new-production-institute/OSAMBot/README.md

# OSAMBot

## Introduction

OSAMBot is a low-cost, open-source, modular telescopic robot designed to support
precision farming through adaptable, locally manufacturable automation.

## Description

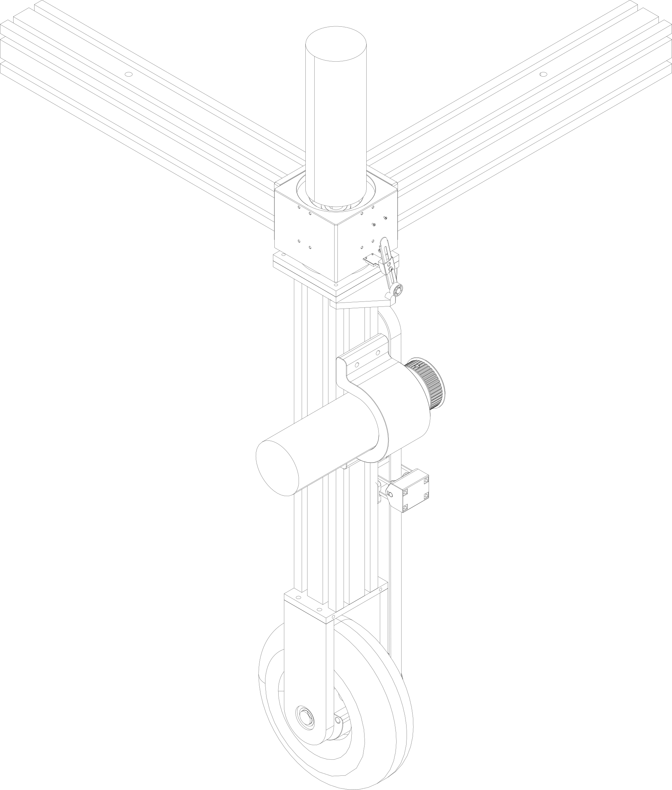
[picture p1: robotic-platform-v1/res/assets/img/osambot.png]
Description


This robot is a low-cost, modular telescopic autonomous agricultural platform
designed to support precision farming. It addresses challenges caused by climate
change. The open-source hardware design follows Fab City principles, aiming to
provide flexible, locally producible robotic solutions for tasks such as
seeding, weeding, and maintaining farm operations.

## Repository structure

The repository is structured with a top-level folder for each version of the
robotic platform, and inside each version directory the files are organized into
`build` (generated STL files), `doc` (documentation), `res` (e.g. datasheets,
manufacturing files, and CAD working assets), and `src` (the main mechanical CAD
assemblies and components).

## License

See the LICENSES folder and the SPDX metadata for more details.  The project is
[REUSE](https://reuse.software/) compliant.

## Authors
- Durga Prasad Babu Nasika (Version 0 and 1)
- SJ (Version 1)
- Joel Romero (Version 0)
- J.C. Mariscal-Melgar (Documentation)

## Acknowledgement
The project "Fab City – Decentralized Digital Production for Urban Value Creation" is funded by dtec.bw and supported by the European Union – NextGenerationEU.
