new-production-institute/OSAMBot/robotic-platform-v1/doc/concept-design/2D-ConceptualDesign-Drive.pdf

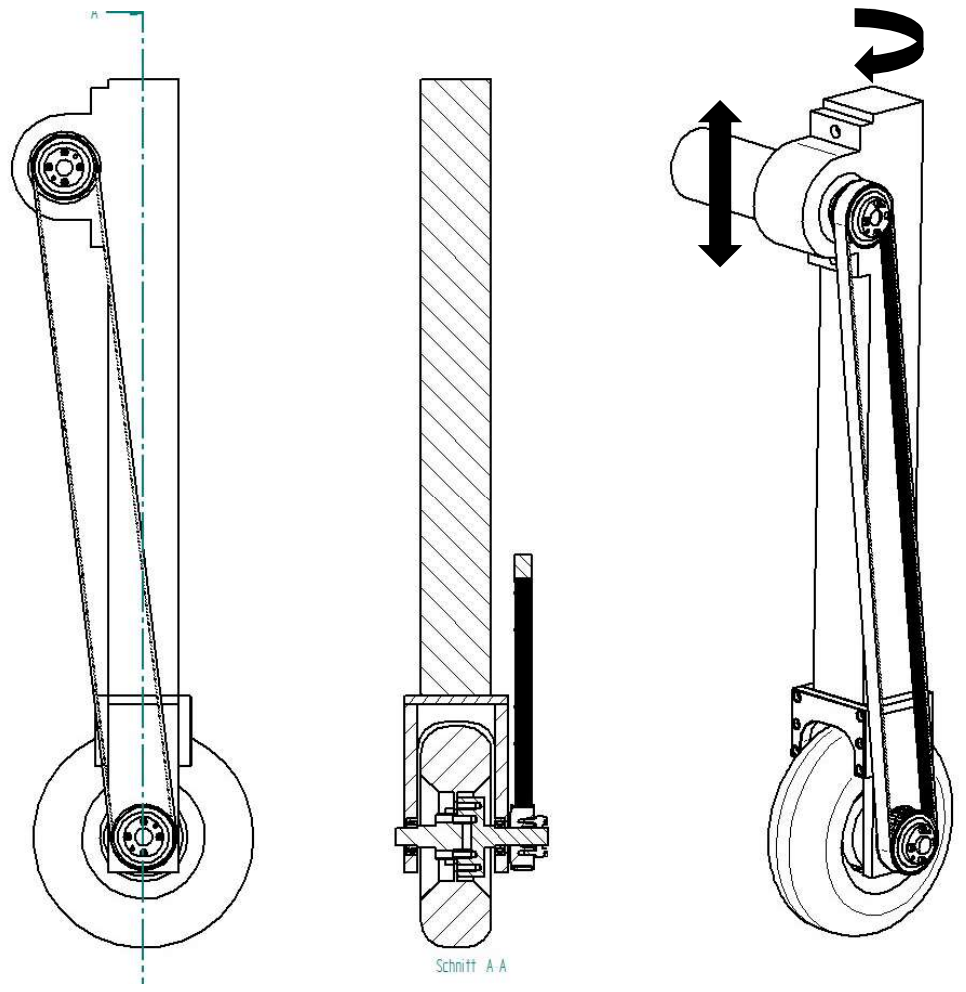
[picture p2: page 1]
