new-production-institute/OSAMBot/robotic-platform-v1/doc/concept-design/2D-ConceptualDesign-Drive.jpg

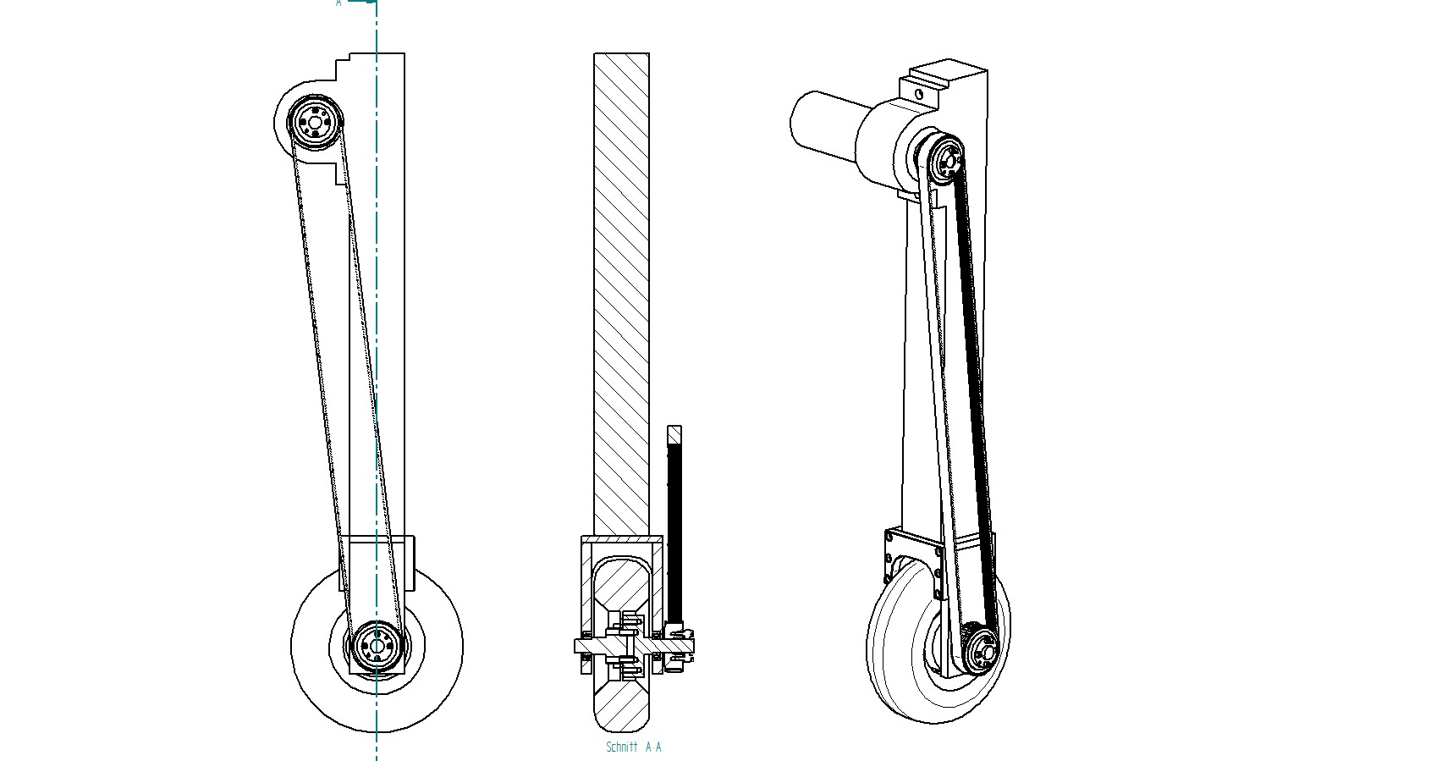
robotic-platform-v1/doc/concept-design/2D-ConceptualDesign-Drive.jpg
