new-production-institute/OSAMBot/robotic-platform-v1/src/mech/assembly-robotic-platform.stp

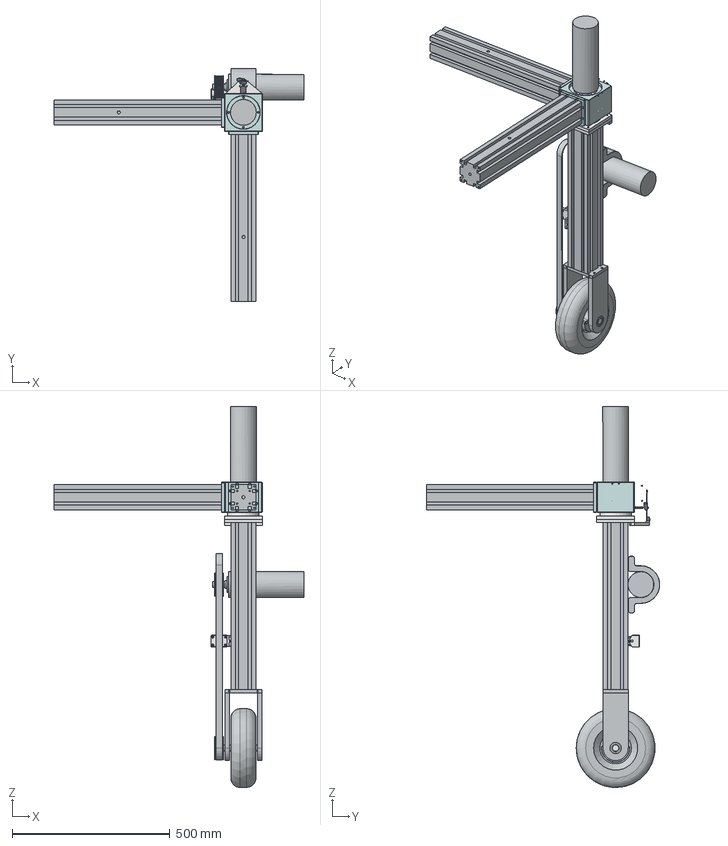
[picture p4: CAD file, 2025-08-19]
robotic-platform-v1/src/mech/assembly-robotic-platform.stp
791.7 x 739.6 x 1207.7 mm
wheel-Maxxis-M-9230TT-252504W-004
vertical-profile-adapter-plate
radial-bearing-6004ZZC3 x 2
bearing-696AZZ x 2
RiemenRolle
pin-D6
Federspanner
drive-shaft-holder(PLA)
profile-adapter-plate-24.03.25 x 2
wheel-bearing-plate x 2
Motor-PL82Z-BL82.137-24300-30S-192_1-ENC1096 x 2
M4x50 x 4
80x80-profile x 3
top-wheel-bearing-plate
drive-shaft-holder-cutout(PLA)
belt
TTLA44T5200-E-20_b-D19-PR
TTLA44T5200-E-20_b-D20-PR
drive-shaft-D20L150
vertical-profile-adapter-plate2
Limit switch ME-8108 x 2
Limit switch ME-8108_0
Limit switch ME-8108_1
Limit switch ME-8108_2 x 3
Limit switch ME-8108_3
Limit switch ME-8108_4
Limit switch ME-8108_5
Limit switch ME-8108_6
Limit switch ME-8108_7
Limit switch ME-8108_8
Limit switch ME-8108_9
radial-bearing x 2
belt-tensioner-angle
limit-switch-plate
drive-motor-holder
bearing-limit-ring
belt-tensioner-angle-glider
steering-motor-adapter-24.03.25
axial-bearing
steering-motor-adapter-shaft
