new-production-institute/OSAMBot/robotic-platform-v1/res/assets/var/manufacturing/02.04.25/drive-shaft-holder_ALU.stp

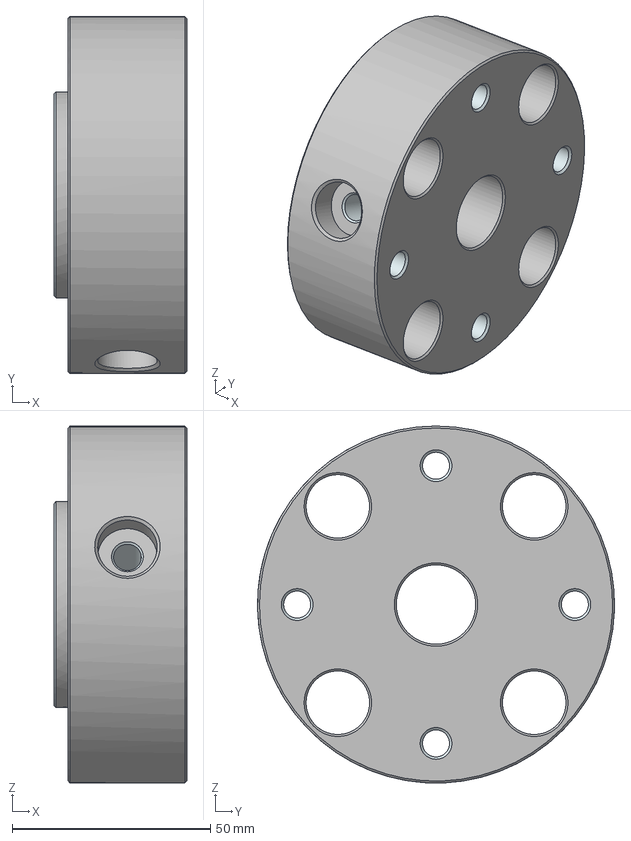
[picture p6: CAD file, 2025-08-19]
robotic-platform-v1/res/assets/var/manufacturing/02.04.25/drive-shaft-holder_ALU.stp
33.5 x 90.0 x 90.0 mm
