new-production-institute/OSAMBot/robotic-platform-v1/res/assets/var/manufacturing/24.03.25/Motorplate.stp

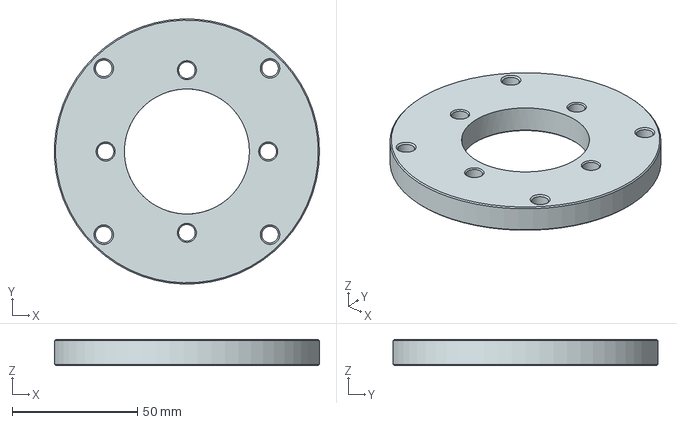
[picture p7: CAD file, 2025-08-19]
robotic-platform-v1/res/assets/var/manufacturing/24.03.25/Motorplate.stp
105.9 x 106.0 x 10.5 mm
