new-production-institute/OSAMBot/robotic-platform-v1/res/assets/var/working-files/helping-prints/Laser alignment/L-Holder.stl

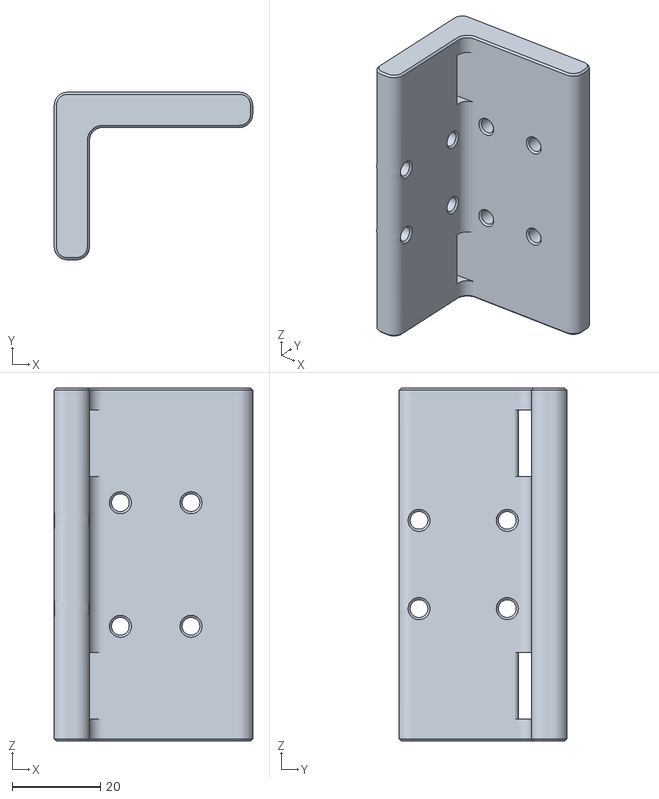
[picture p8: CAD file, 2025-08-19]
robotic-platform-v1/res/assets/var/working-files/helping-prints/Laser alignment/L-Holder.stl
45.0 x 38.0 x 80.0
