new-production-institute/OSAMBot/robotic-platform-v1/res/assets/var/working-files/helping-prints/RK-30-Lifter.stl

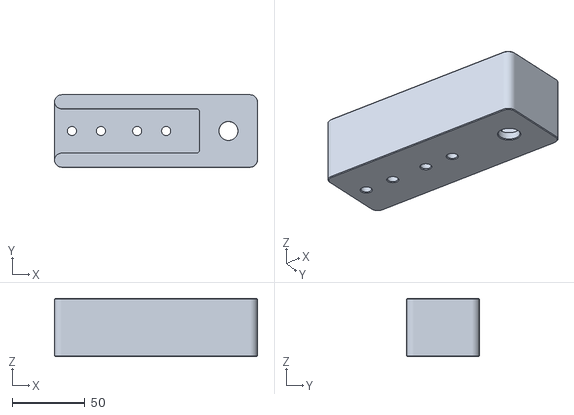
[picture p9: CAD file, 2025-08-19]
robotic-platform-v1/res/assets/var/working-files/helping-prints/RK-30-Lifter.stl
140.0 x 50.0 x 40.0
