new-production-institute/OSAMBot/robotic-platform-v1/res/assets/var/working-files/laser-parts/LensHolder80W-Galvo-side.stl

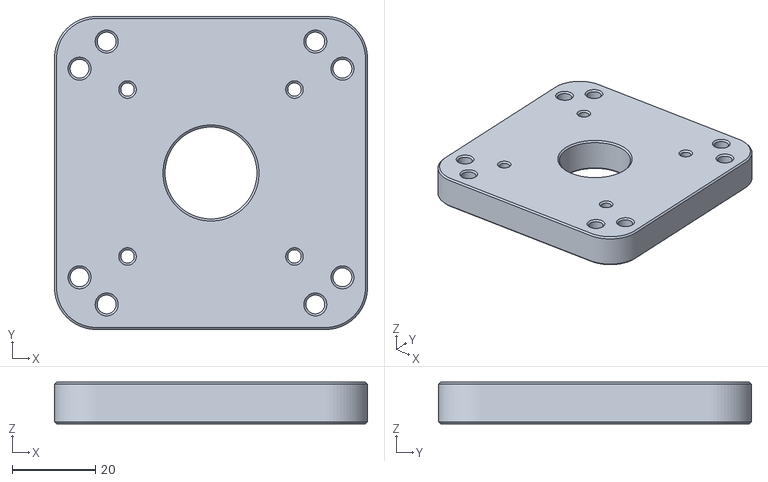
[picture p10: CAD file, 2025-08-19]
robotic-platform-v1/res/assets/var/working-files/laser-parts/LensHolder80W-Galvo-side.stl
75.0 x 75.0 x 10.0
