new-production-institute/OSAMBot/robotic-platform-v1/res/assets/var/working-files/simplified-model/Wheel.stp

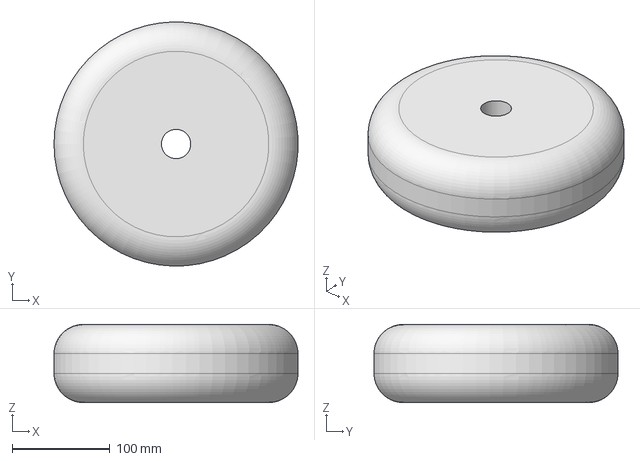
[picture p11: CAD file, 2025-08-19]
robotic-platform-v1/res/assets/var/working-files/simplified-model/Wheel.stp
249.8 x 249.9 x 80.0 mm
