new-production-institute/OSAMBot/robotic-platform-v1/src/mech/assembly-robotic-platform-individual-parts/drive-motor-holder.stp

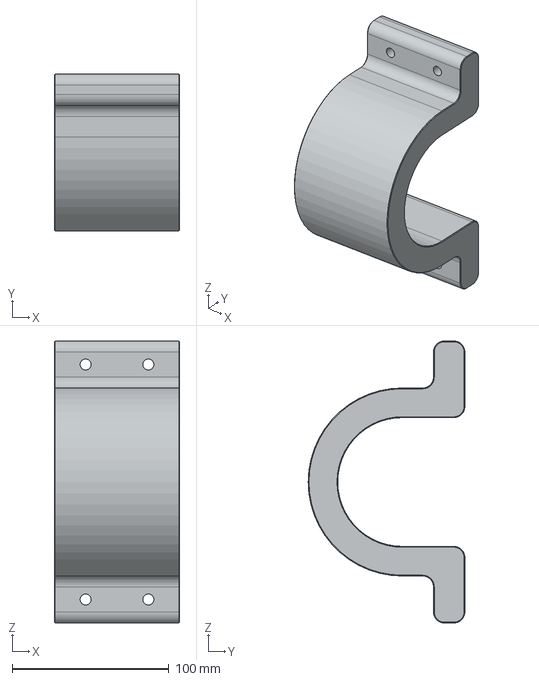
[picture p12: CAD file, 2025-08-19]
robotic-platform-v1/src/mech/assembly-robotic-platform-individual-parts/drive-motor-holder.stp
80.0 x 100.0 x 180.0 mm
