new-production-institute/OSAMBot/robotic-platform-v1/build/TTLA44T5200-E-20_b-D20-PR.stl

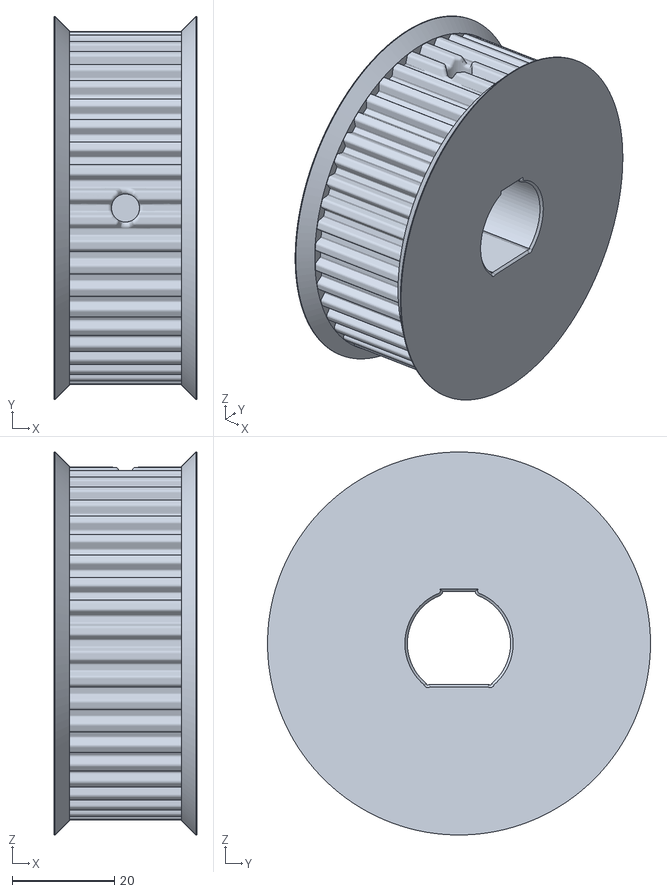
[picture p13: CAD file, 2025-08-19]
robotic-platform-v1/build/TTLA44T5200-E-20_b-D20-PR.stl
28.0 x 75.0 x 75.0
