new-production-institute/OSAMBot/robotic-platform-v1/res/assets/var/manufacturing/24.03.25/ProfilAdapterplate-24.03.25.stp

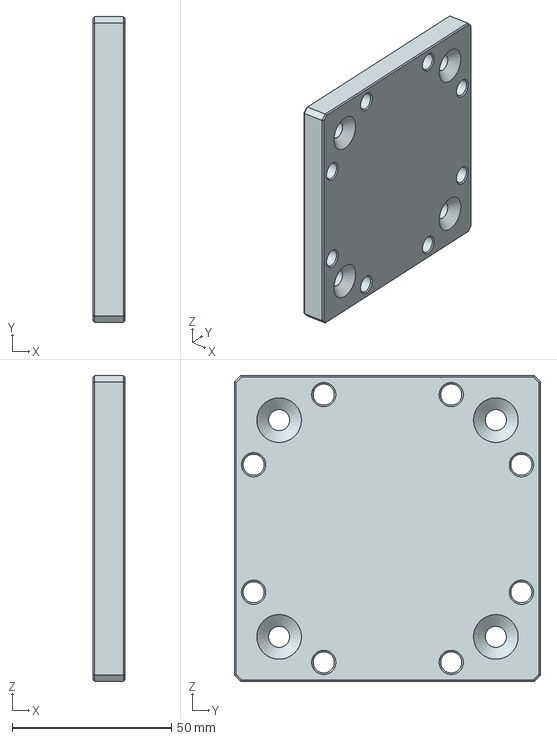
[picture p14: CAD file, 2025-08-19]
robotic-platform-v1/res/assets/var/manufacturing/24.03.25/ProfilAdapterplate-24.03.25.stp
10.0 x 96.0 x 96.0 mm
