new-production-institute/OSAMBot/robotic-platform-v1/res/assets/var/working-files/helping-prints/Distanzring.stl

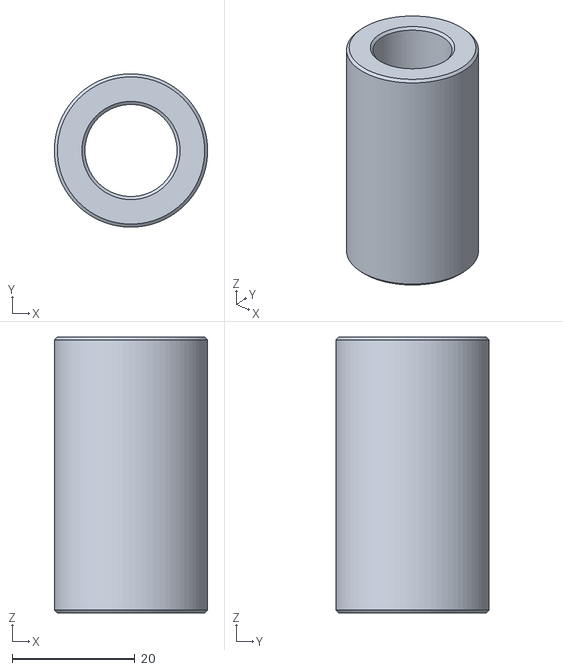
[picture p15: CAD file, 2025-08-19]
robotic-platform-v1/res/assets/var/working-files/helping-prints/Distanzring.stl
25.0 x 25.0 x 45.0
