new-production-institute/OSAMBot/robotic-platform-v1/res/assets/var/working-files/helping-prints/Laser alignment/Cover-L-Side.stl

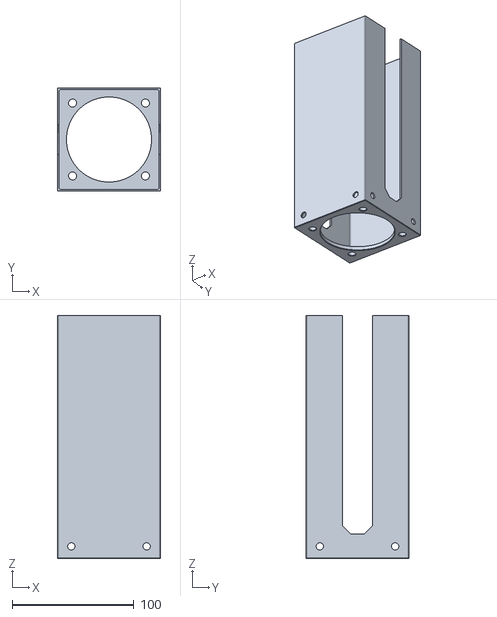
[picture p16: CAD file, 2025-08-19]
robotic-platform-v1/res/assets/var/working-files/helping-prints/Laser alignment/Cover-L-Side.stl
85.0 x 85.0 x 200.0
