new-production-institute/OSAMBot/robotic-platform-v1/res/assets/var/working-files/laser-parts/LensHolder80W-Laser-side.stl

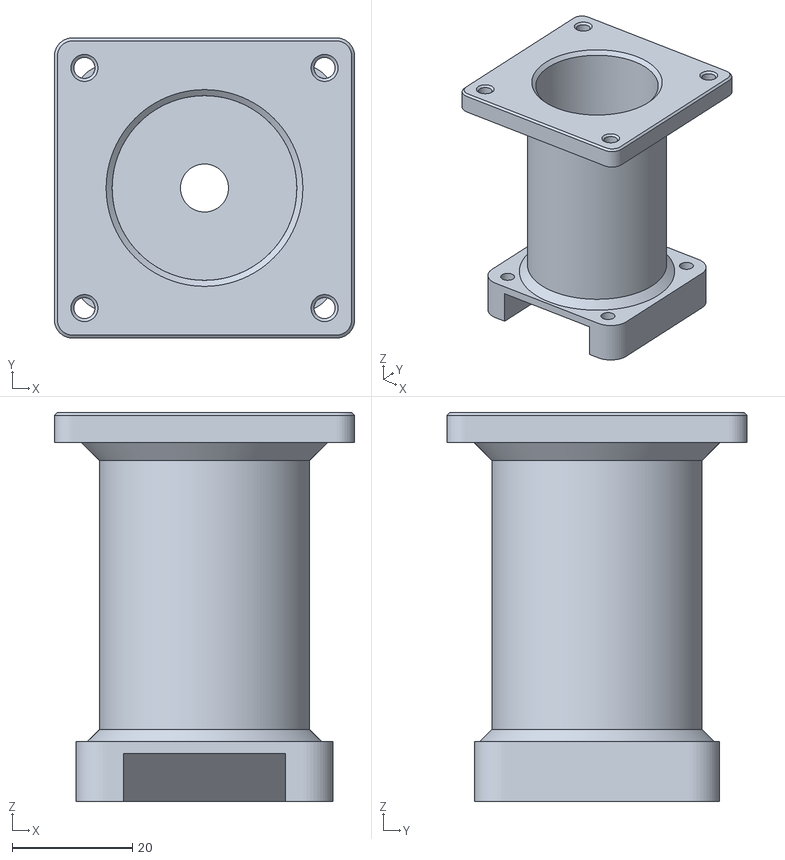
[picture p17: CAD file, 2025-08-19]
robotic-platform-v1/res/assets/var/working-files/laser-parts/LensHolder80W-Laser-side.stl
50.0 x 50.0 x 64.8
