new-production-institute/OSAMBot/robotic-platform-v1/res/assets/var/working-files/simplified-model/Leg.stp

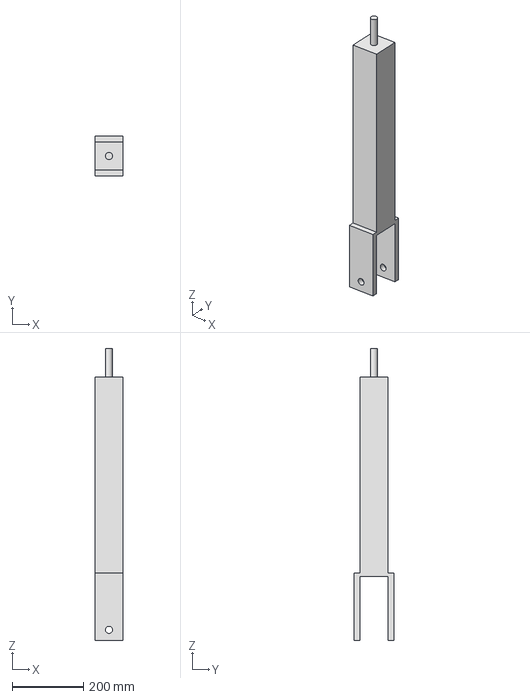
[picture p18: CAD file, 2025-08-19]
robotic-platform-v1/res/assets/var/working-files/simplified-model/Leg.stp
80.0 x 112.0 x 820.0 mm
