new-production-institute/OSAMBot/robotic-platform-v1/src/mech/assembly-robotic-platform-individual-parts/Limit switch ME-8108.stp

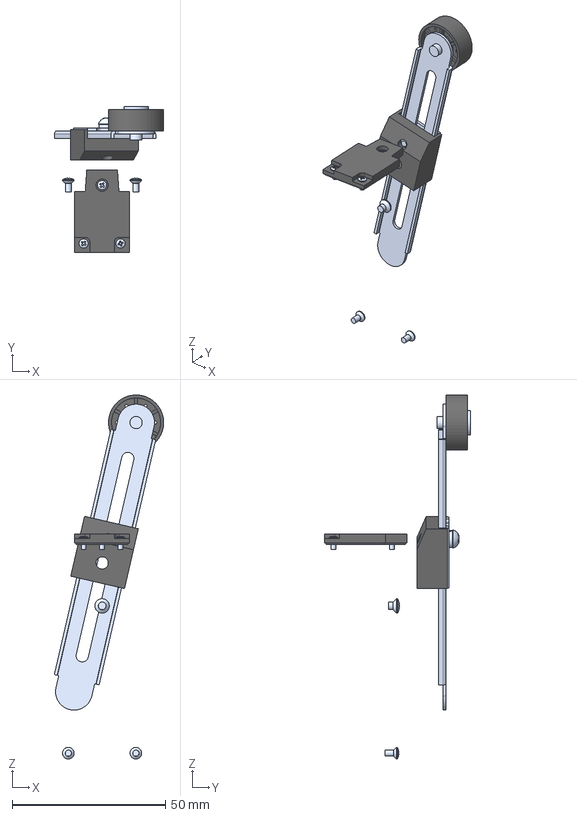
[picture p19: CAD file, 2025-08-19]
robotic-platform-v1/src/mech/assembly-robotic-platform-individual-parts/Limit switch ME-8108.stp
35.6 x 47.7 x 118.6 mm
Limit switch ME-8108 x 2
Limit switch ME-8108_0
Limit switch ME-8108_1
Limit switch ME-8108_2 x 3
Limit switch ME-8108_3
Limit switch ME-8108_4
Limit switch ME-8108_5
Limit switch ME-8108_6
Limit switch ME-8108_7
Limit switch ME-8108_8
Limit switch ME-8108_9
