new-production-institute/OSAMBot/robotic-platform-v1/res/assets/var/manufacturing/24.03.25/SteeringMotorAdapter-24.03.25.stp

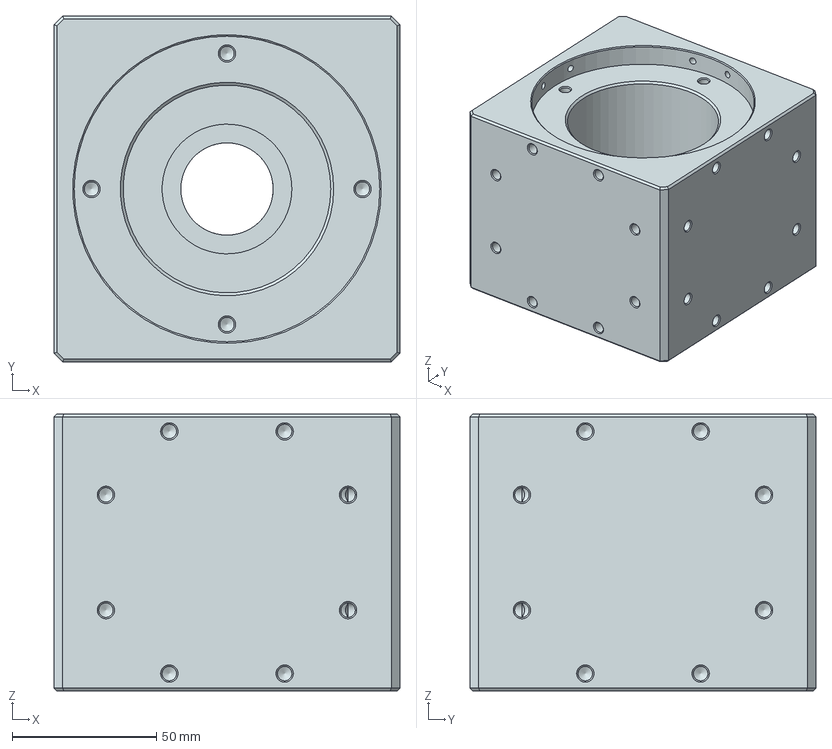
[picture p20: CAD file, 2025-08-19]
robotic-platform-v1/res/assets/var/manufacturing/24.03.25/SteeringMotorAdapter-24.03.25.stp
120.0 x 120.0 x 96.0 mm
