new-production-institute/OSAMBot/robotic-platform-v1/res/assets/var/working-files/helping-prints/Laser alignment/Linear-Holder.stl

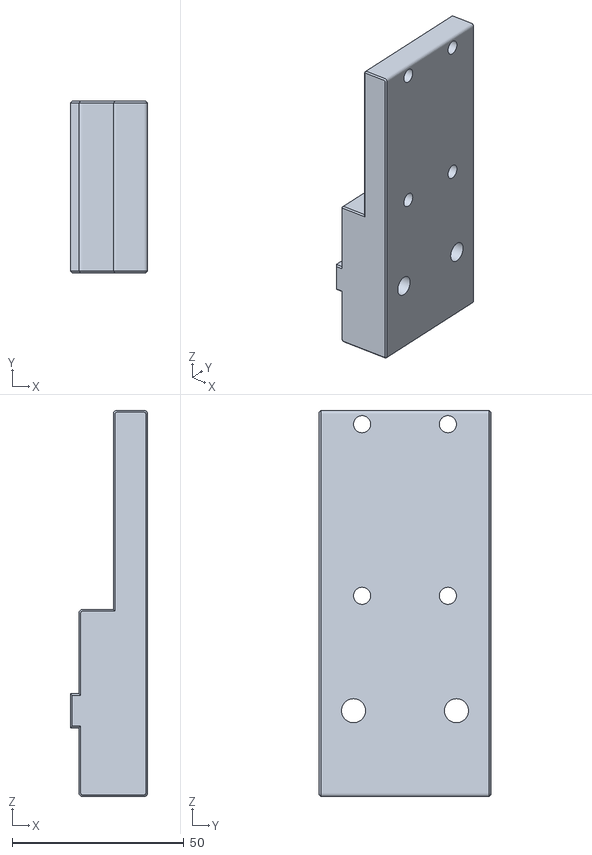
[picture p21: CAD file, 2025-08-19]
robotic-platform-v1/res/assets/var/working-files/helping-prints/Laser alignment/Linear-Holder.stl
22.5 x 50.0 x 112.5
