new-production-institute/OSAMBot/robotic-platform-v1/res/assets/var/working-files/helping-prints/M12-Guide.stl

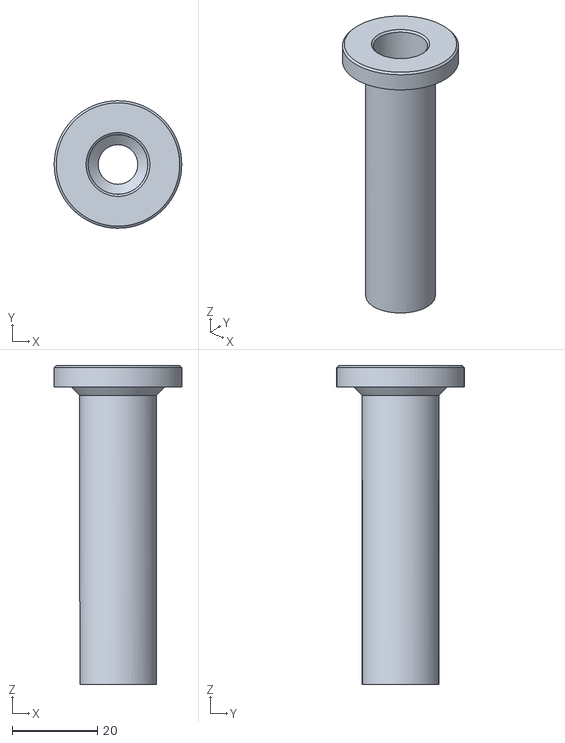
[picture p22: CAD file, 2025-08-19]
robotic-platform-v1/res/assets/var/working-files/helping-prints/M12-Guide.stl
30.0 x 30.0 x 75.0
