new-production-institute/OSAMBot/robotic-platform-v1/res/assets/var/working-files/simplified-model/Simplified-Joint-Model.stp

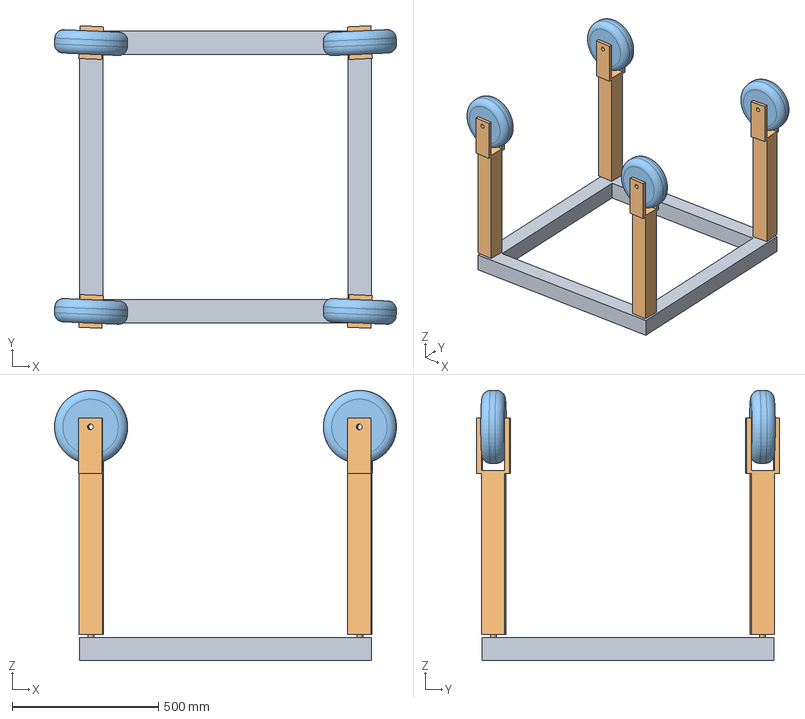
[picture p23: CAD file, 2025-08-19]
robotic-platform-v1/res/assets/var/working-files/simplified-model/Simplified-Joint-Model.stp
1170.6 x 1035.5 x 925.0 mm
Frame
Leg x 4
Wheel x 4
