new-production-institute/OSAMBot/robotic-platform-v1/src/mech/assembly-robotic-platform-individual-parts/top-wheel-bearing-plate.stp

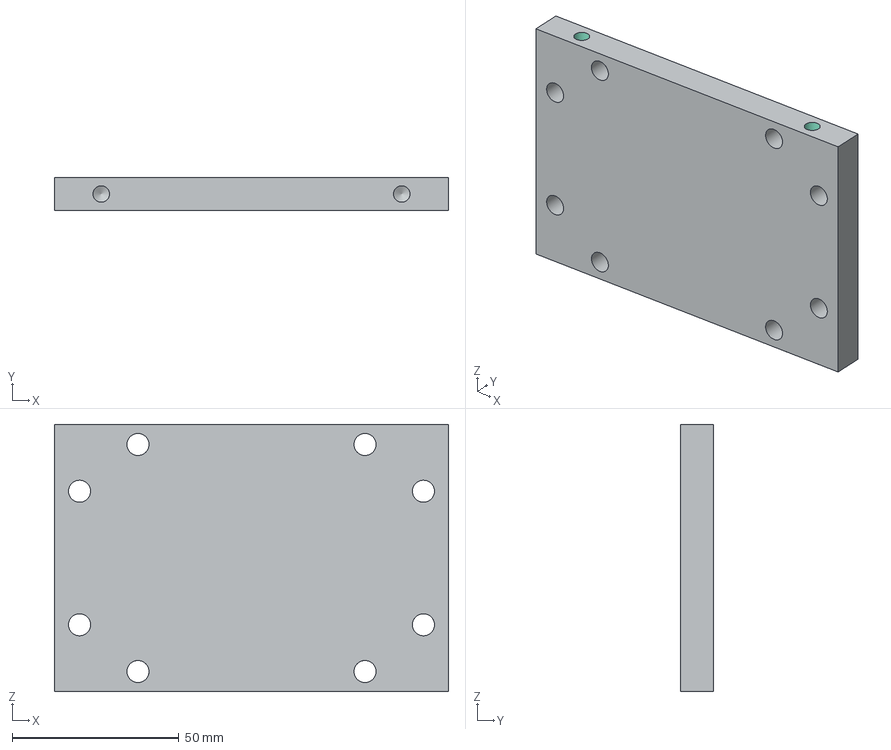
[picture p24: CAD file, 2025-08-19]
robotic-platform-v1/src/mech/assembly-robotic-platform-individual-parts/top-wheel-bearing-plate.stp
118.0 x 10.0 x 80.0 mm
