new-production-institute/OSAMBot/robotic-platform-v1/build/belt-tensioner-angle-glider.stl

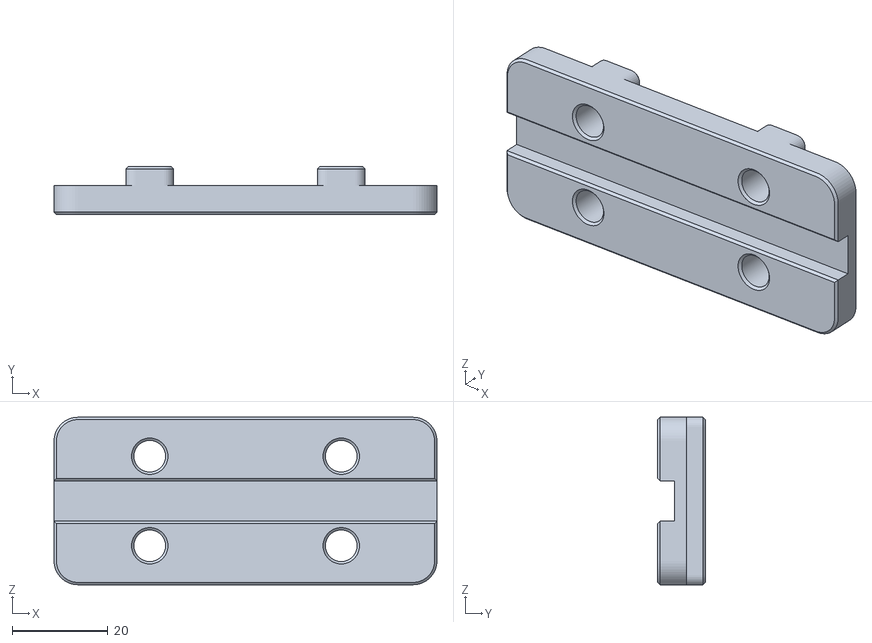
[picture p25: CAD file, 2025-08-19]
robotic-platform-v1/build/belt-tensioner-angle-glider.stl
80.0 x 10.0 x 35.0
