new-production-institute/OSAMBot/robotic-platform-v1/res/assets/var/working-files/helping-prints/drilling-template-3.stl

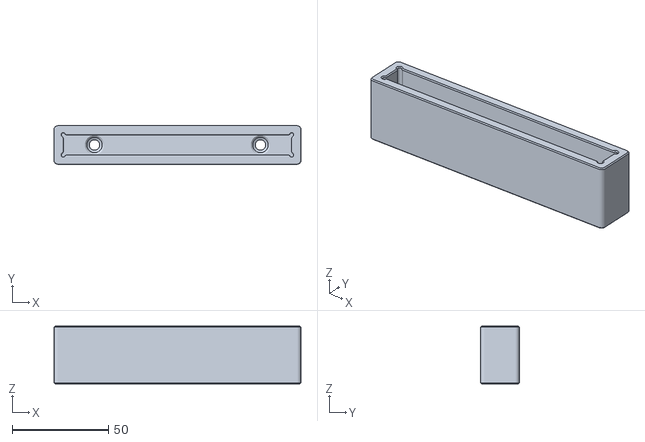
[picture p26: CAD file, 2025-08-19]
robotic-platform-v1/res/assets/var/working-files/helping-prints/drilling-template-3.stl
128.0 x 20.0 x 30.0
