new-production-institute/OSAMBot/robotic-platform-v1/res/assets/var/working-files/helping-prints/Laser alignment/L-HolderV2-T2.stl

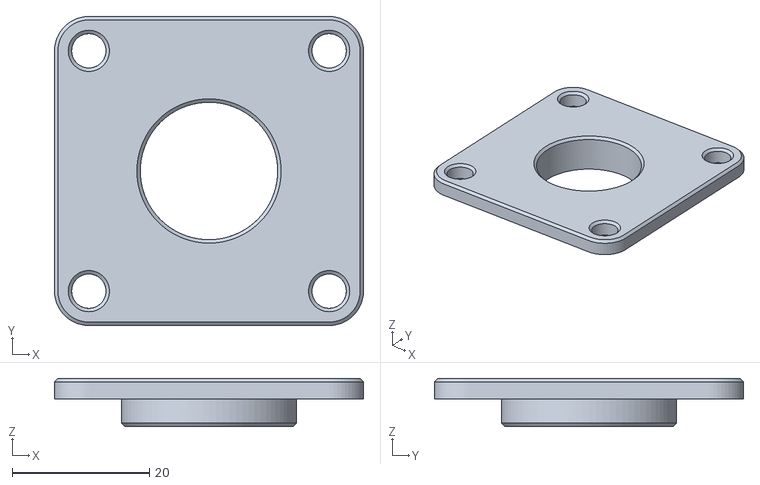
[picture p27: CAD file, 2025-08-19]
robotic-platform-v1/res/assets/var/working-files/helping-prints/Laser alignment/L-HolderV2-T2.stl
45.0 x 45.0 x 7.00
