new-production-institute/OSAMBot/robotic-platform-v1/res/assets/var/working-files/simplified-model/Frame.stp

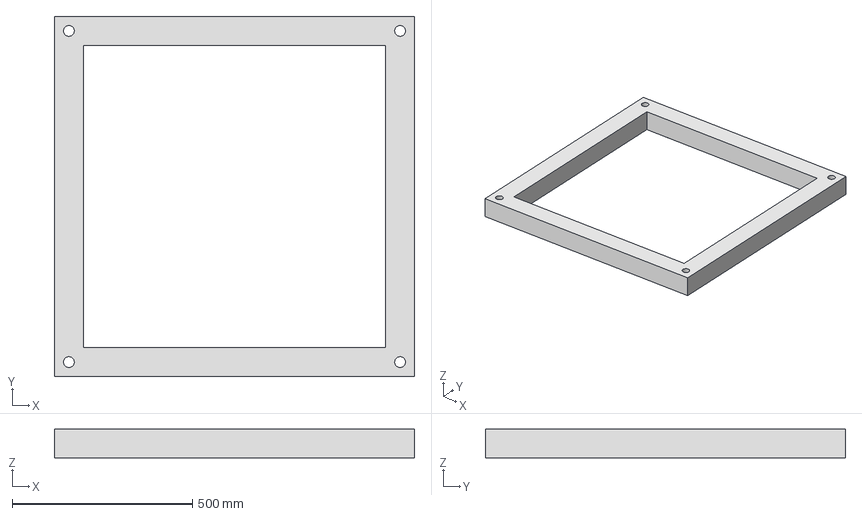
[picture p28: CAD file, 2025-08-19]
robotic-platform-v1/res/assets/var/working-files/simplified-model/Frame.stp
1000.0 x 1000.0 x 80.0 mm
