new-production-institute/OSAMBot/robotic-platform-v1/build/Zahnrad-Profil-8M-P24-8M-20-6F.stl

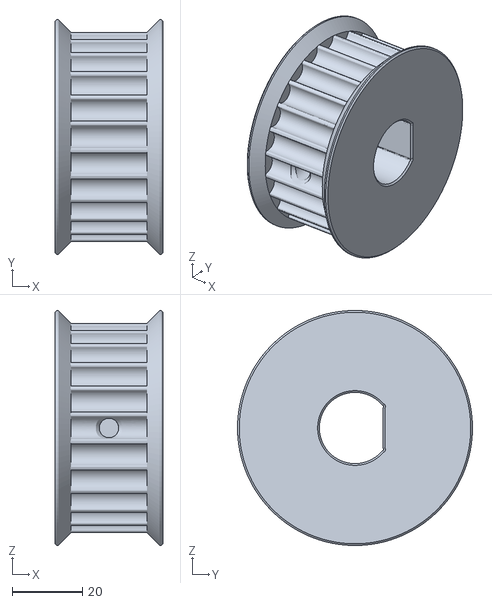
[picture p29: CAD file, 2025-08-19]
robotic-platform-v1/build/Zahnrad-Profil-8M-P24-8M-20-6F.stl
30.7 x 66.7 x 66.7
