new-production-institute/OSAMBot/robotic-platform-v1/res/assets/var/working-files/helping-prints/Laser alignment/Tube-inner.stl

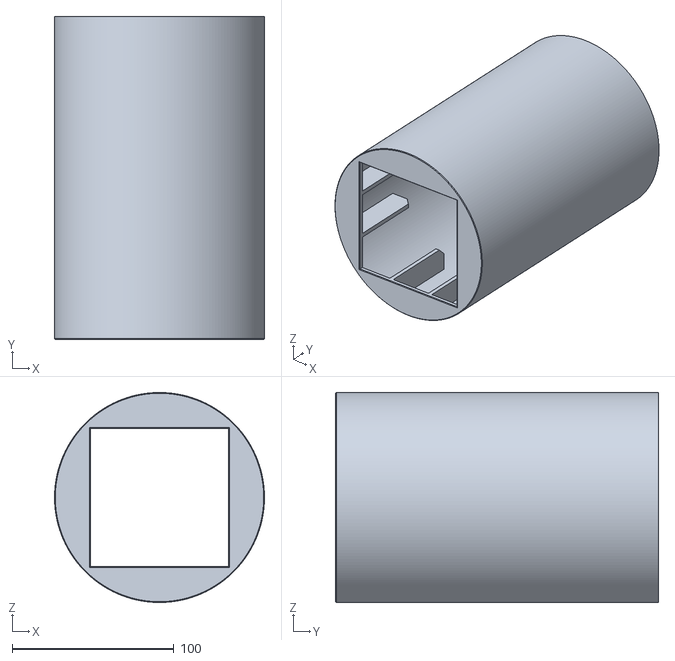
[picture p30: CAD file, 2025-08-19]
robotic-platform-v1/res/assets/var/working-files/helping-prints/Laser alignment/Tube-inner.stl
130.0 x 200.0 x 130.0
