new-production-institute/OSAMBot/robotic-platform-v1/res/assets/var/working-files/helping-prints/M12-Stuetze.stl

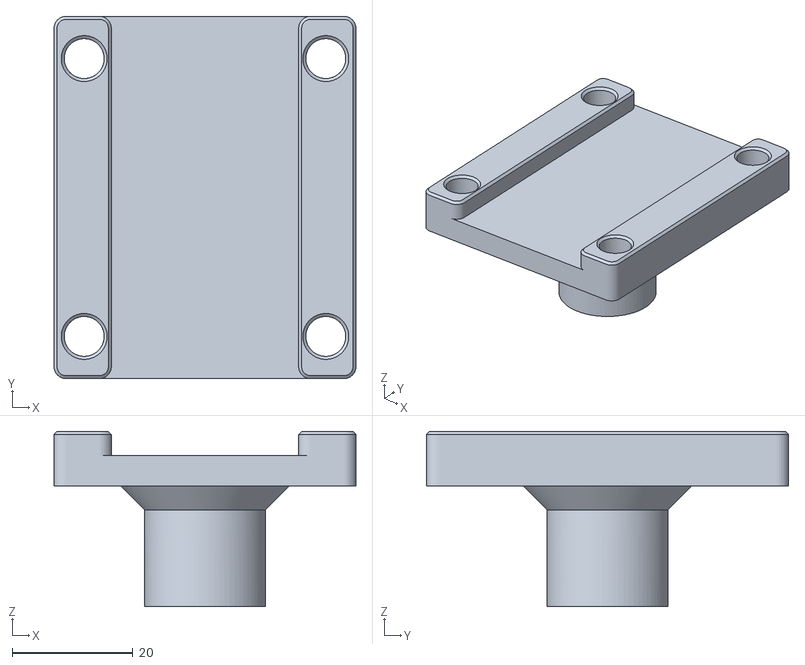
[picture p31: CAD file, 2025-08-19]
robotic-platform-v1/res/assets/var/working-files/helping-prints/M12-Stuetze.stl
50.0 x 60.0 x 29.0
