new-production-institute/OSAMBot/robotic-platform-v1/src/mech/assembly-robotic-platform-individual-parts/drive-shaft-holder(PLA).stp

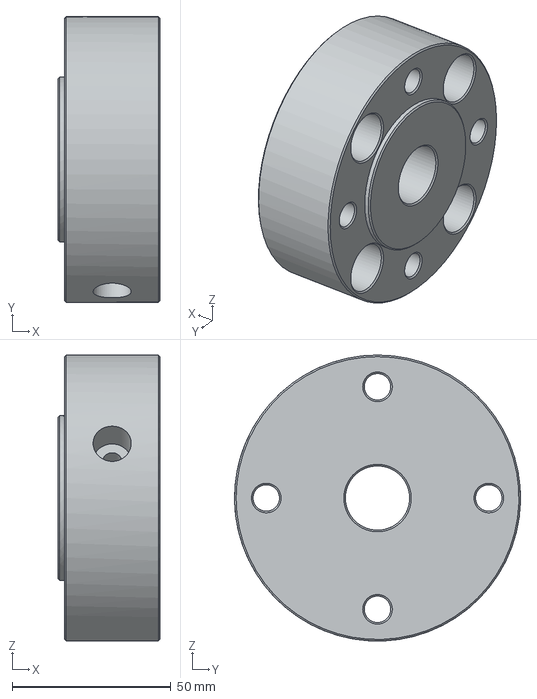
[picture p32: CAD file, 2025-08-19]
robotic-platform-v1/src/mech/assembly-robotic-platform-individual-parts/drive-shaft-holder(PLA).stp
32.0 x 90.0 x 90.0 mm
