new-production-institute/OSAMBot/robotic-platform-v1/build/drive-shaft-holder-cutout(PLA).stl

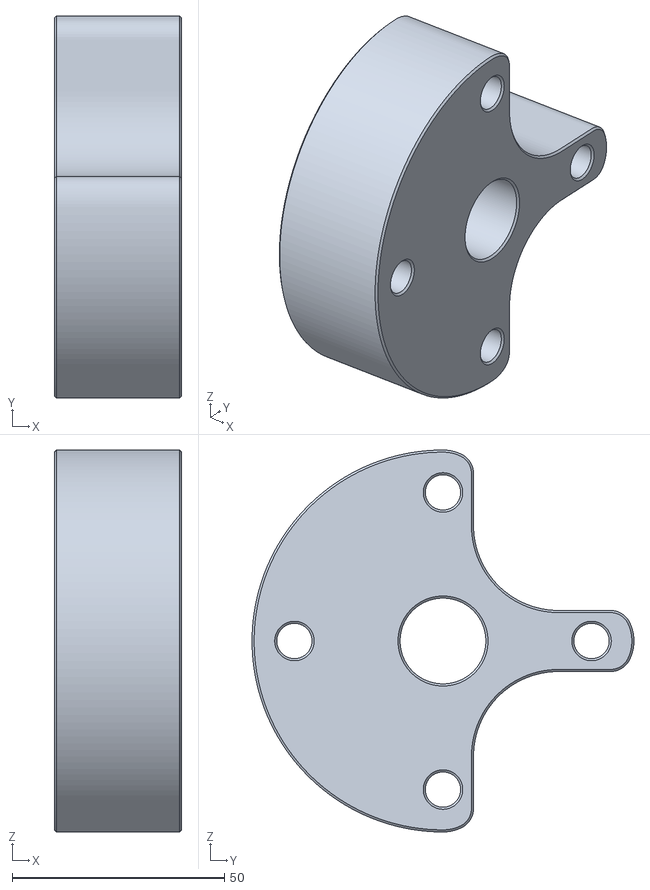
[picture p33: CAD file, 2025-08-19]
robotic-platform-v1/build/drive-shaft-holder-cutout(PLA).stl
30.0 x 90.0 x 90.0
