new-production-institute/OSAMBot/robotic-platform-v1/res/assets/var/working-files/helping-prints/drilling-template-2.stl

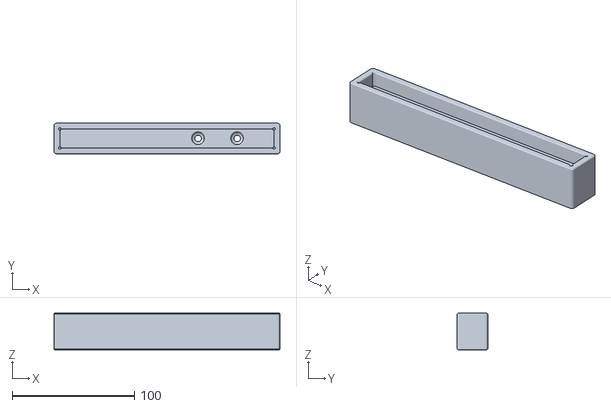
[picture p34: CAD file, 2025-08-19]
robotic-platform-v1/res/assets/var/working-files/helping-prints/drilling-template-2.stl
185.0 x 25.0 x 30.0
