new-production-institute/OSAMBot/robotic-platform-v1/res/assets/var/working-files/helping-prints/Laser alignment/Cover-G-Side.stl

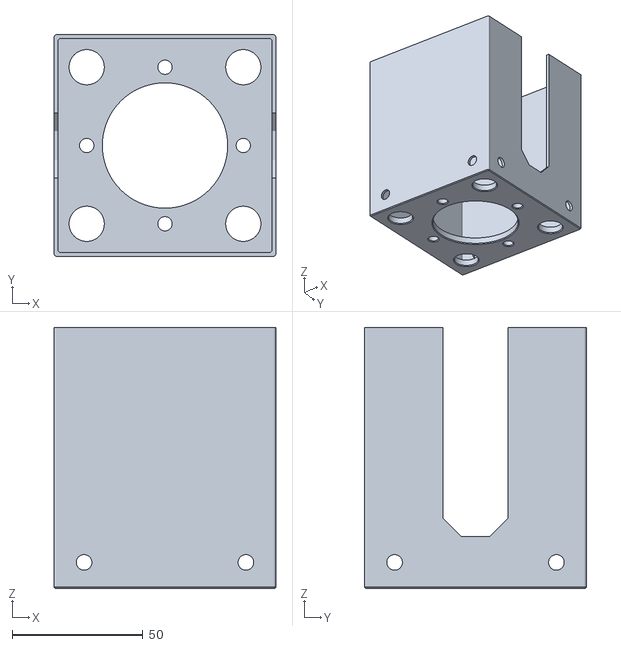
[picture p35: CAD file, 2025-08-19]
robotic-platform-v1/res/assets/var/working-files/helping-prints/Laser alignment/Cover-G-Side.stl
85.0 x 85.0 x 100.0
