new-production-institute/OSAMBot/robotic-platform-v1/build/spring-housing.stl

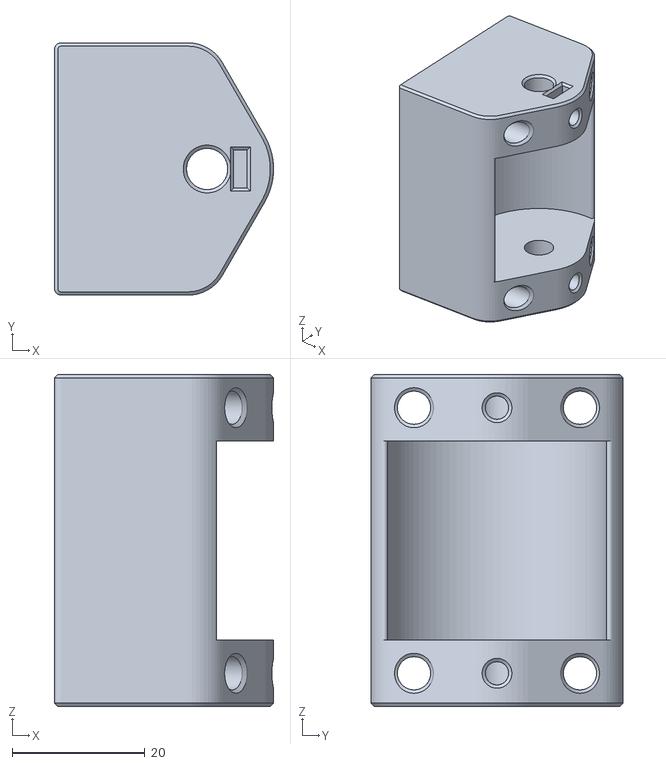
[picture p36: CAD file, 2025-08-19]
robotic-platform-v1/build/spring-housing.stl
33.0 x 38.0 x 50.0
