new-production-institute/OSAMBot/robotic-platform-v1/res/assets/var/working-files/helping-prints/drilling-template-1.stl

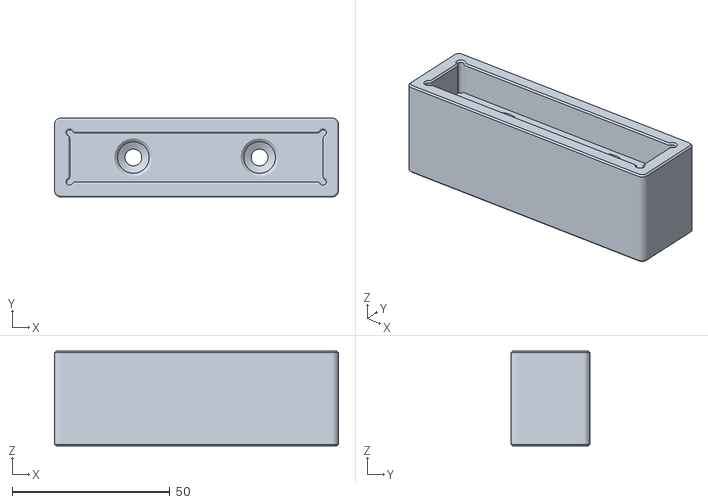
[picture p37: CAD file, 2025-08-19]
robotic-platform-v1/res/assets/var/working-files/helping-prints/drilling-template-1.stl
90.0 x 25.0 x 30.0
