new-production-institute/OSAMBot/robotic-platform-v1/res/assets/var/working-files/helping-prints/Laser alignment/L-HolderV2.stl

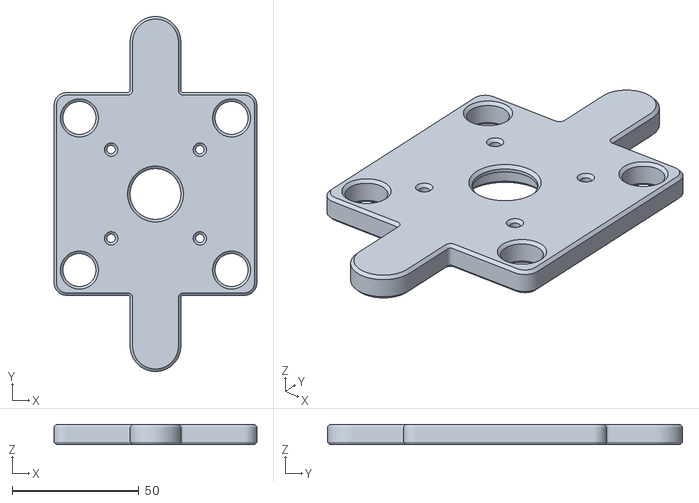
[picture p38: CAD file, 2025-08-19]
robotic-platform-v1/res/assets/var/working-files/helping-prints/Laser alignment/L-HolderV2.stl
80.0 x 140.0 x 8.00
