new-production-institute/OSAMBot/robotic-platform-v1/src/mech/assembly-robotic-platform-individual-parts/bearing-limit-ring-V2.stp

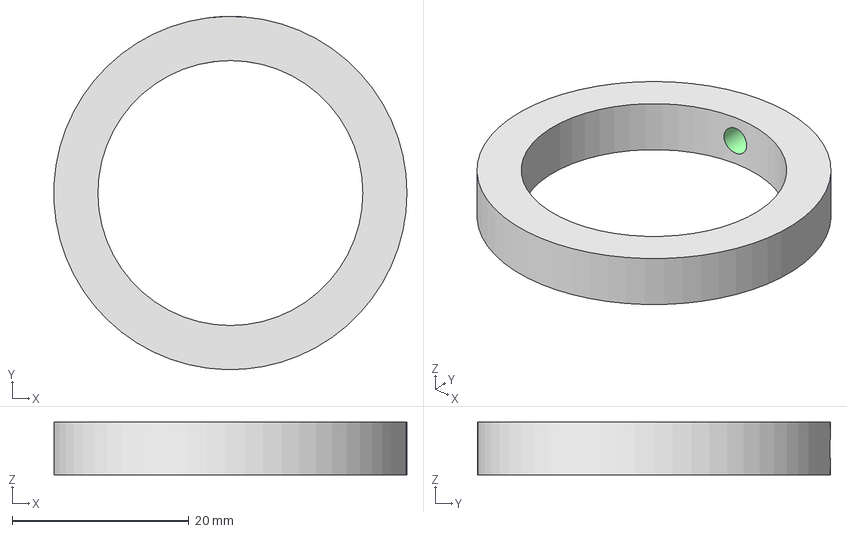
[picture p39: CAD file, 2025-08-19]
robotic-platform-v1/src/mech/assembly-robotic-platform-individual-parts/bearing-limit-ring-V2.stp
40.0 x 40.0 x 6.00 mm
