new-production-institute/OSAMBot/robotic-platform-v1/res/assets/var/working-files/helping-prints/Laser alignment/Distanzring2.stl

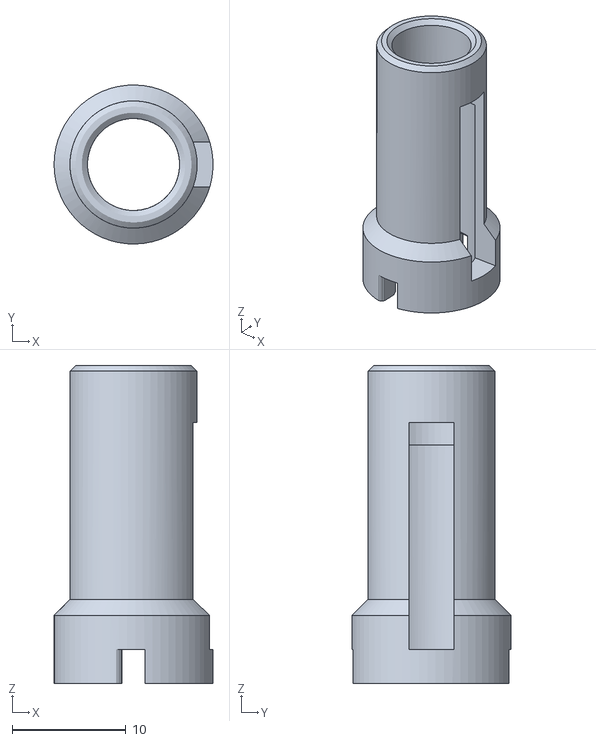
[picture p40: CAD file, 2025-08-19]
robotic-platform-v1/res/assets/var/working-files/helping-prints/Laser alignment/Distanzring2.stl
14.0 x 14.0 x 28.0
