new-production-institute/OSAMBot/robotic-platform-v1/src/mech/assembly-robotic-platform-individual-parts/TTLA44T5200-E-20_b-D19-PR.stp

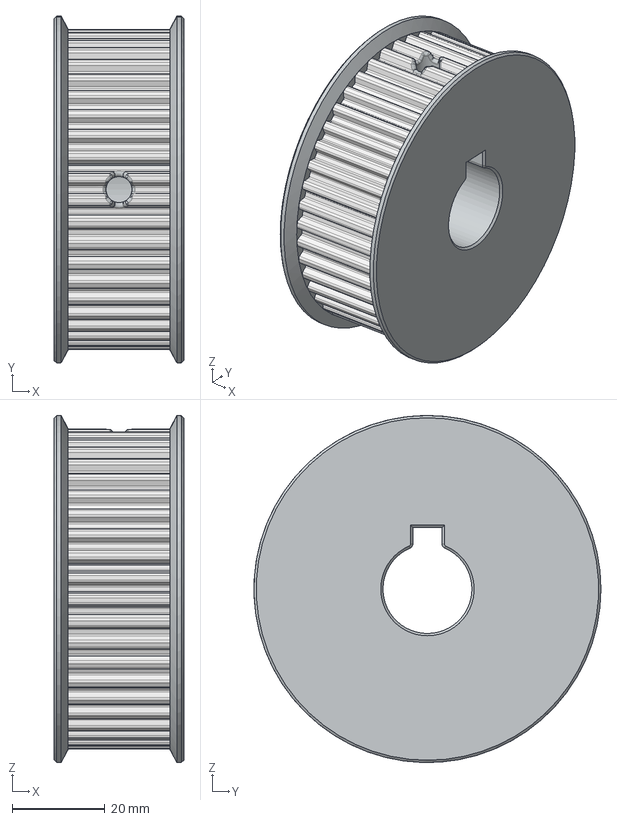
[picture p41: CAD file, 2025-08-19]
robotic-platform-v1/src/mech/assembly-robotic-platform-individual-parts/TTLA44T5200-E-20_b-D19-PR.stp
28.0 x 75.0 x 75.0 mm
