new-production-institute/OSAMBot/robotic-platform-v1/build/RiemenRolle.stl

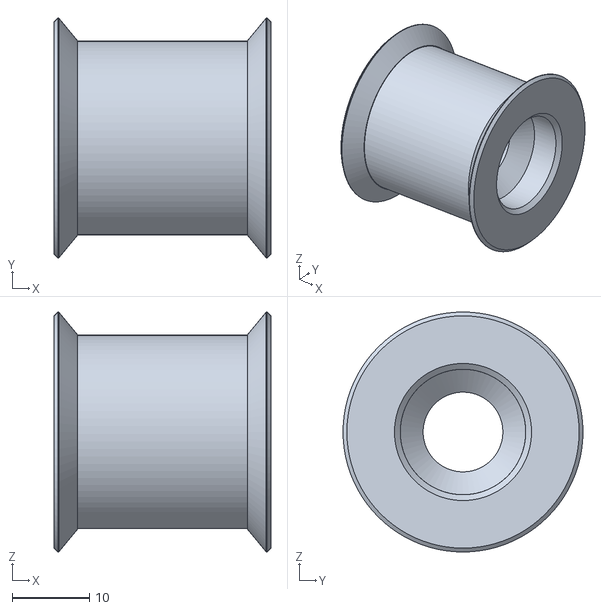
[picture p42: CAD file, 2025-08-19]
robotic-platform-v1/build/RiemenRolle.stl
28.0 x 31.0 x 31.0
