new-production-institute/OSAMBot/robotic-platform-v1/res/assets/var/working-files/helping-prints/Laser alignment/L-Klemme.stl

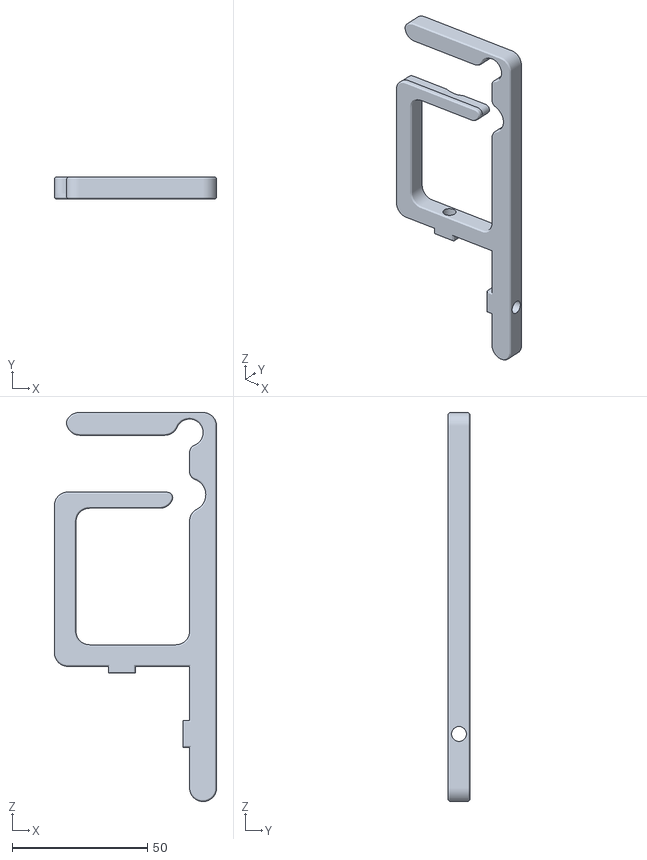
[picture p45: CAD file, 2025-08-19]
robotic-platform-v1/res/assets/var/working-files/helping-prints/Laser alignment/L-Klemme.stl
60.0 x 8.00 x 143.9
