new-production-institute/OSAMBot/robotic-platform-v1/src/mech/assembly-robotic-platform-individual-parts/bearing-696AZZ.stp

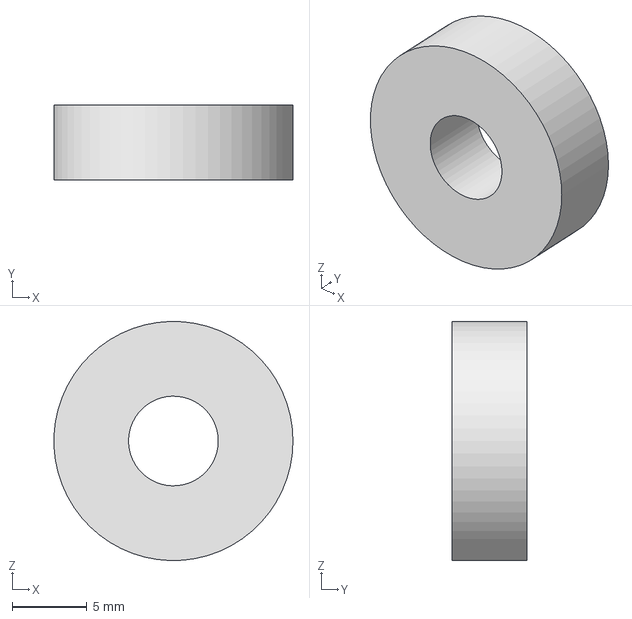
[picture p46: CAD file, 2025-08-19]
robotic-platform-v1/src/mech/assembly-robotic-platform-individual-parts/bearing-696AZZ.stp
16.0 x 5.00 x 16.0 mm
