new-production-institute/OSAMBot/robotic-platform-v1/build/limit-switch-plate.stl

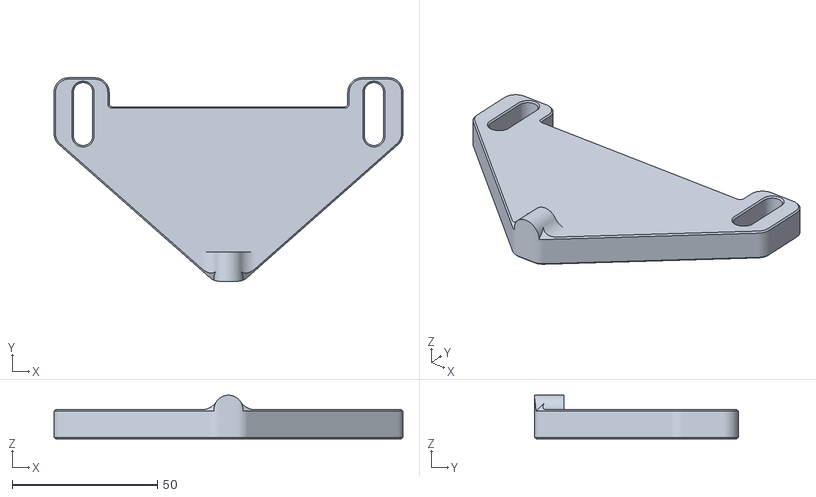
[picture p47: CAD file, 2025-08-19]
robotic-platform-v1/build/limit-switch-plate.stl
120.0 x 70.0 x 15.0
