new-production-institute/OSAMBot/robotic-platform-v1/src/mech/assembly-robotic-platform-individual-parts/wheel-Maxxis-M-9230TT-252504W-004.stp

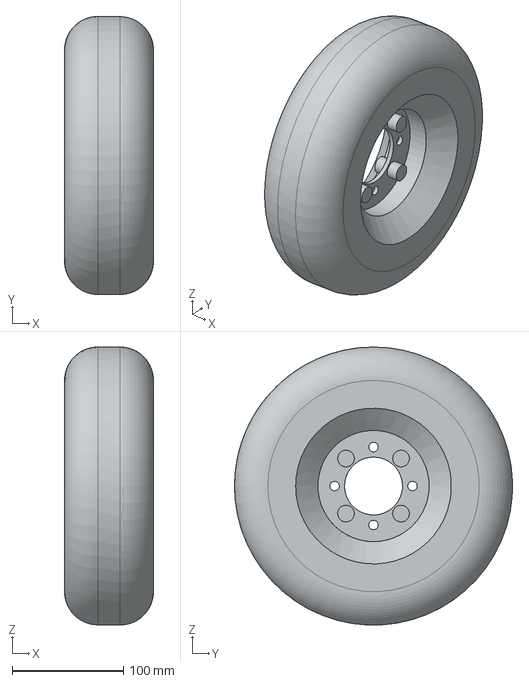
[picture p48: CAD file, 2025-08-19]
robotic-platform-v1/src/mech/assembly-robotic-platform-individual-parts/wheel-Maxxis-M-9230TT-252504W-004.stp
80.0 x 250.0 x 249.9 mm
