new-production-institute/OSAMBot/robotic-platform-v1/src/mech/assembly-robotic-platform-individual-parts/radial-bearing-6004ZZC3.stp

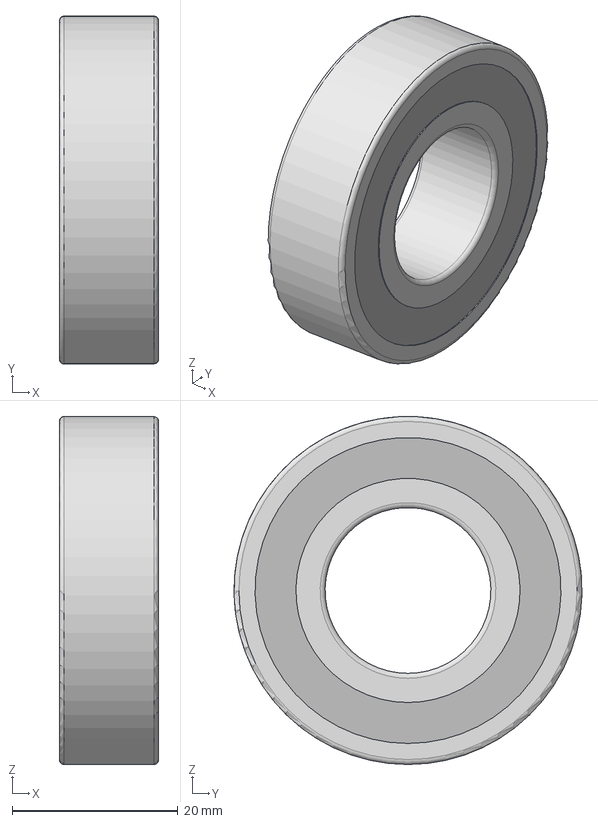
[picture p49: CAD file, 2025-08-19]
robotic-platform-v1/src/mech/assembly-robotic-platform-individual-parts/radial-bearing-6004ZZC3.stp
12.0 x 42.0 x 42.0 mm
