new-production-institute/OSAMBot/robotic-platform-v1/src/mech/assembly-robotic-platform-individual-parts/axial-bearing.stp

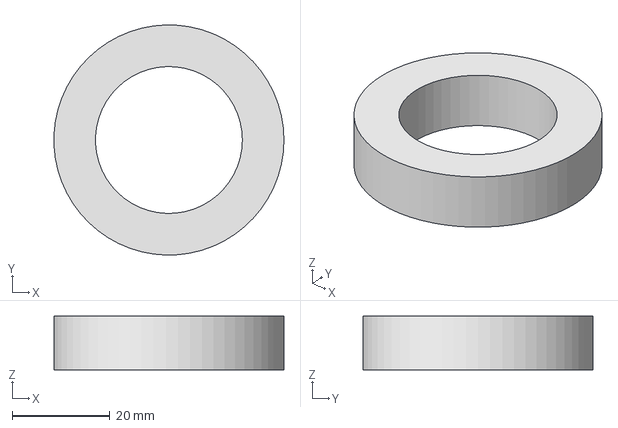
[picture p50: CAD file, 2025-08-19]
robotic-platform-v1/src/mech/assembly-robotic-platform-individual-parts/axial-bearing.stp
47.0 x 47.0 x 11.0 mm
