new-production-institute/OSAMBot/robotic-platform-v1/src/mech/assembly-robotic-platform-individual-parts/80x80-profile.stp

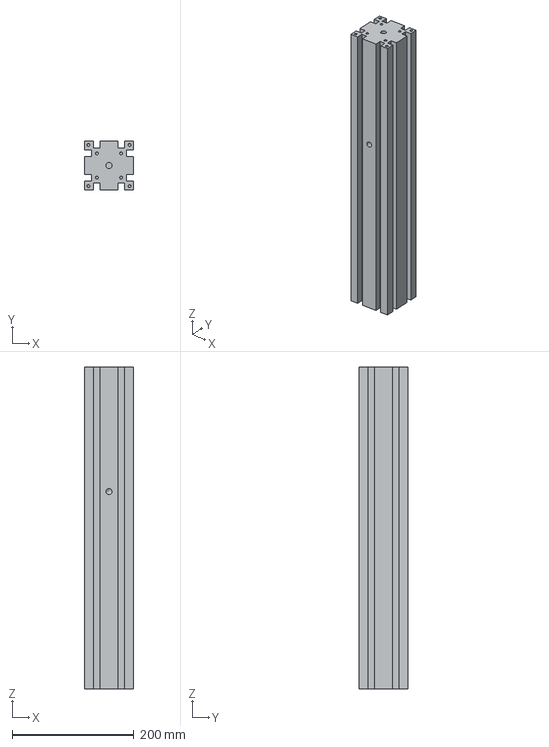
[picture p52: CAD file, 2025-08-19]
robotic-platform-v1/src/mech/assembly-robotic-platform-individual-parts/80x80-profile.stp
80.0 x 80.0 x 530.0 mm
