new-production-institute/OSAMBot/robotic-platform-v1/src/mech/assembly-robotic-platform-individual-parts/belt-tensioner-roll.stp

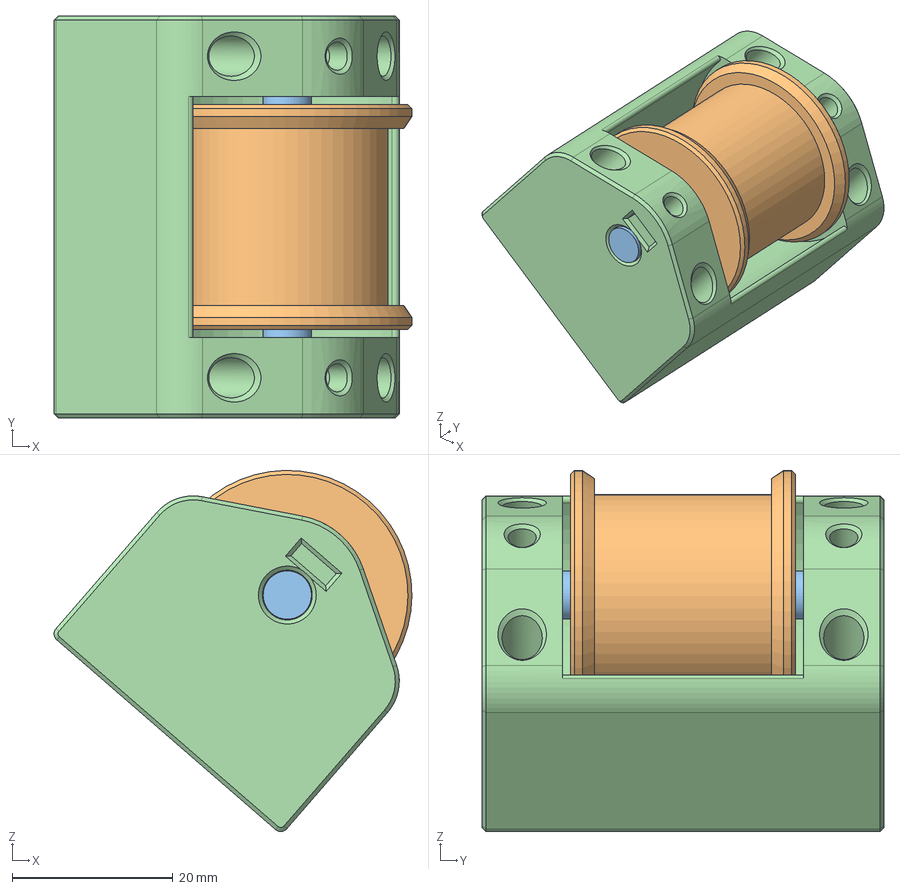
[picture p53: CAD file, 2025-08-19]
robotic-platform-v1/src/mech/assembly-robotic-platform-individual-parts/belt-tensioner-roll.stp
44.5 x 50.0 x 44.9 mm
bearing-696AZZ x 2
RiemenRolle
pin-D6
Federspanner
