new-production-institute/OSAMBot/robotic-platform-v1/src/mech/assembly-robotic-platform-individual-parts/steering-motor-adapter-shaft.stp

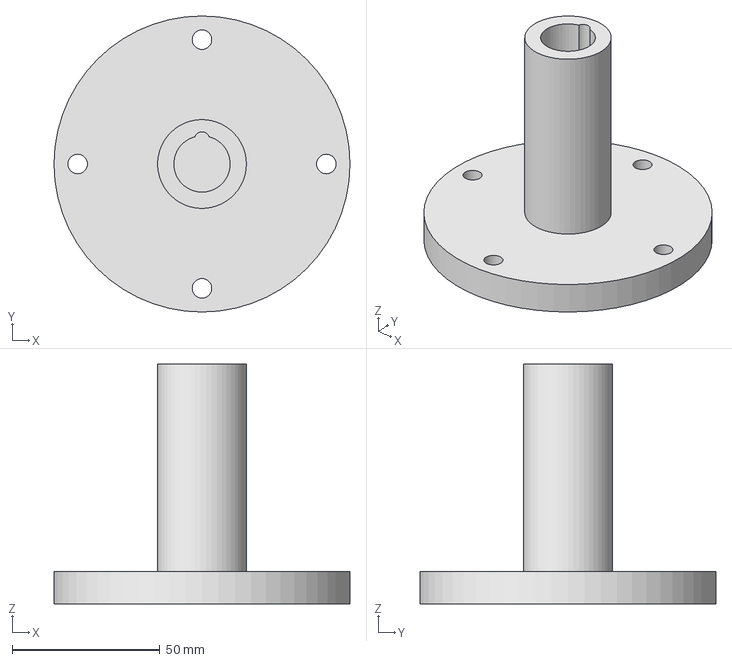
[picture p54: CAD file, 2025-08-19]
robotic-platform-v1/src/mech/assembly-robotic-platform-individual-parts/steering-motor-adapter-shaft.stp
100.0 x 100.0 x 81.0 mm
