new-production-institute/OSAMBot/robotic-platform-v1/src/mech/assembly-robotic-platform-individual-parts/Motor-PL82Z-BL82.137-24300-30S-192_1-ENC1096.stp

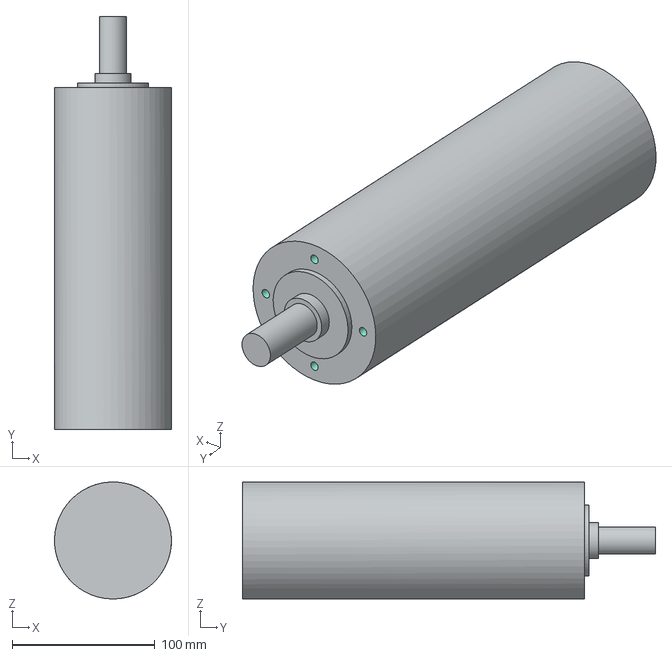
[picture p55: CAD file, 2025-08-19]
robotic-platform-v1/src/mech/assembly-robotic-platform-individual-parts/Motor-PL82Z-BL82.137-24300-30S-192_1-ENC1096.stp
82.0 x 289.5 x 82.0 mm
