new-production-institute/OSAMBot/robotic-platform-v1/src/mech/assembly-robotic-platform-individual-parts/wheel-bearing-plate.stp

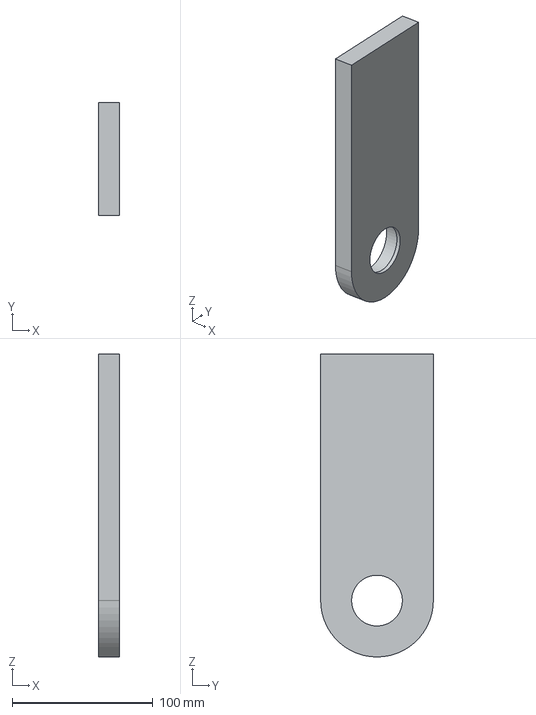
[picture p56: CAD file, 2025-08-19]
robotic-platform-v1/src/mech/assembly-robotic-platform-individual-parts/wheel-bearing-plate.stp
15.0 x 80.0 x 215.0 mm
