new-production-institute/OSAMBot/robotic-platform-v1/src/mech/assembly-robotic-platform-individual-parts/drive-shaft-D20L150.stp

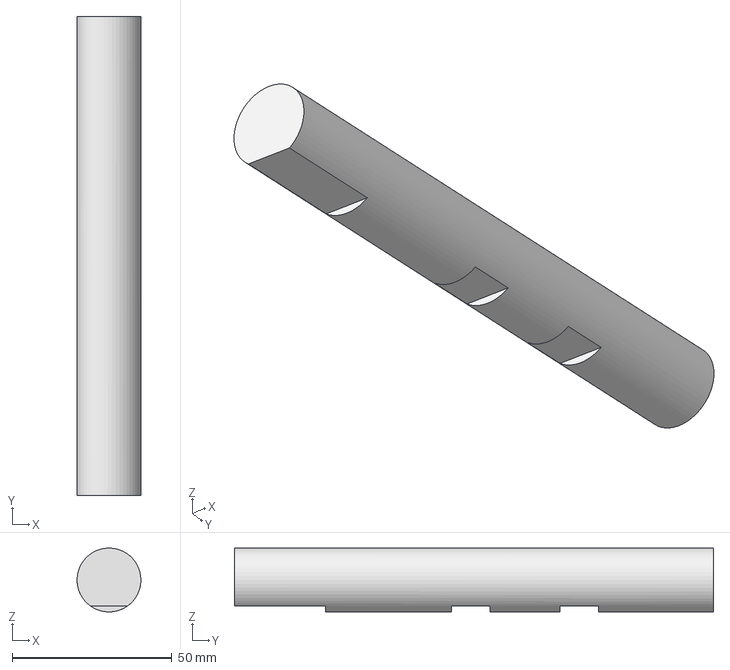
[picture p57: CAD file, 2025-08-19]
robotic-platform-v1/src/mech/assembly-robotic-platform-individual-parts/drive-shaft-D20L150.stp
20.0 x 150.0 x 20.0 mm
