new-production-institute/OSAMBot/robotic-platform-v1/src/mech/assembly-robotic-platform-individual-parts/radial-bearing.stp

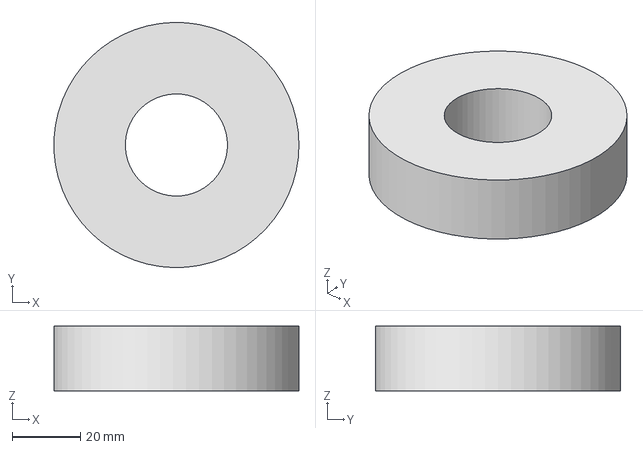
[picture p58: CAD file, 2025-08-19]
robotic-platform-v1/src/mech/assembly-robotic-platform-individual-parts/radial-bearing.stp
71.9 x 72.0 x 19.0 mm
