new-production-institute/OSAMBot/robotic-platform-v1/src/mech/assembly-robotic-platform-individual-parts/pin-D6.stp

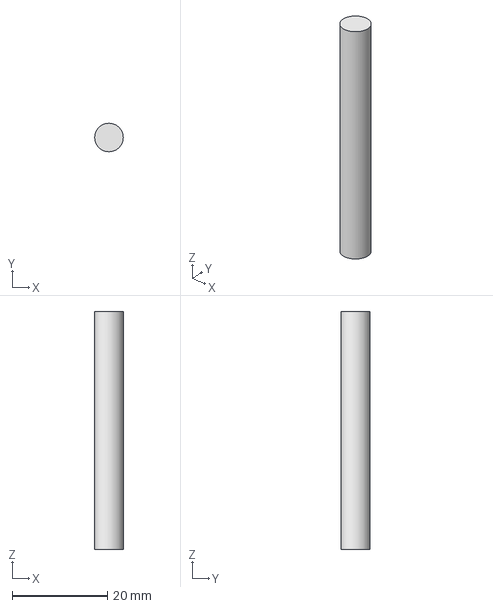
[picture p59: CAD file, 2025-08-19]
robotic-platform-v1/src/mech/assembly-robotic-platform-individual-parts/pin-D6.stp
5.99 x 6.00 x 50.0 mm
