new-production-institute/OSAMBot/robotic-platform-v1/src/mech/assembly-robotic-platform-individual-parts/belt-tensioner-angle.stp

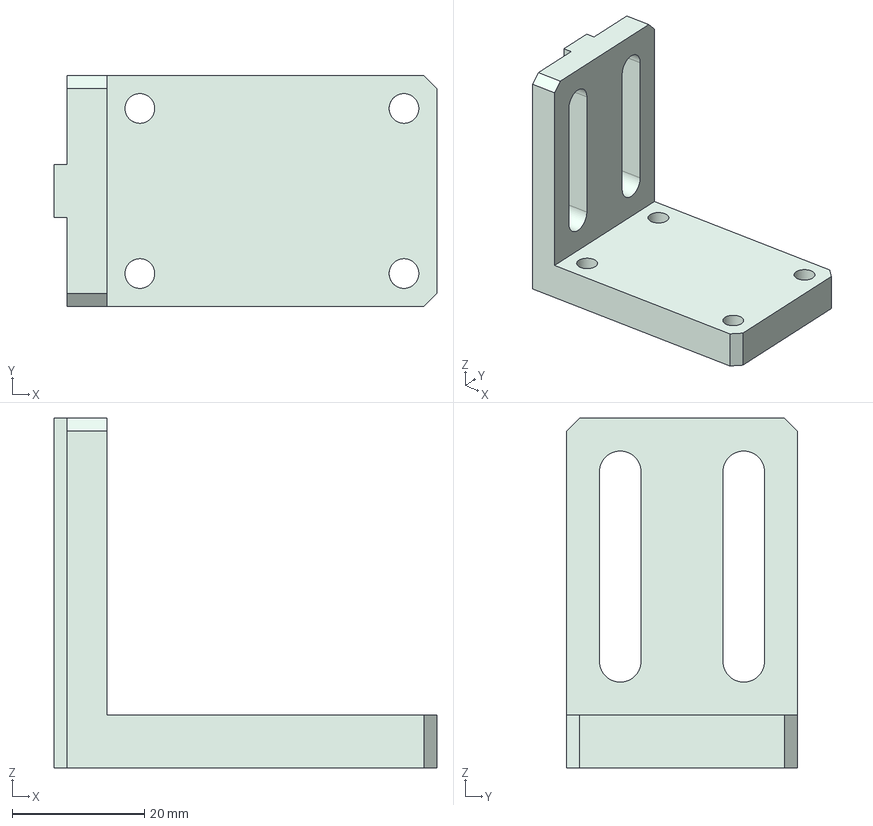
[picture p60: CAD file, 2025-08-19]
robotic-platform-v1/src/mech/assembly-robotic-platform-individual-parts/belt-tensioner-angle.stp
58.0 x 35.0 x 53.0 mm
