new-production-institute/OSAMBot/robotic-platform-v1/src/mech/assembly-robotic-platform-individual-parts/vertical-profile-adapter-plate.stp

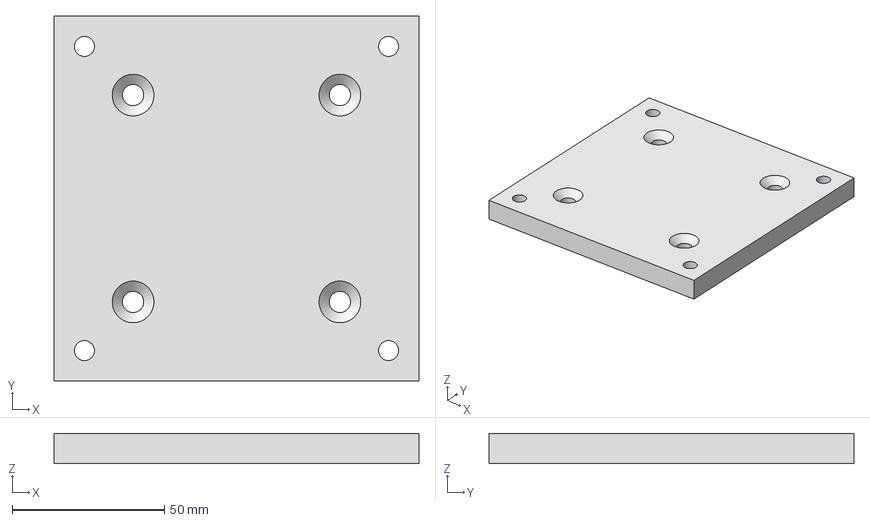
[picture p61: CAD file, 2025-08-19]
robotic-platform-v1/src/mech/assembly-robotic-platform-individual-parts/vertical-profile-adapter-plate.stp
120.0 x 120.0 x 10.0 mm
