new-production-institute/OSAMBot/robotic-platform-v1/src/mech/assembly-robotic-platform-individual-parts/RiemenRolle.stp

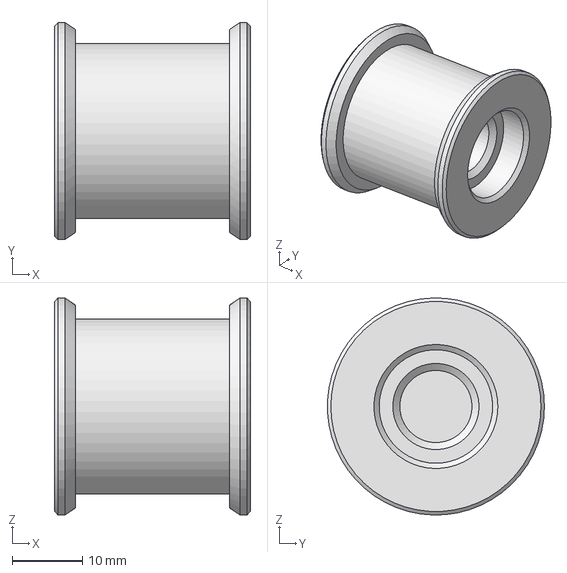
[picture p62: CAD file, 2025-08-19]
robotic-platform-v1/src/mech/assembly-robotic-platform-individual-parts/RiemenRolle.stp
28.0 x 31.0 x 31.0 mm
