new-production-institute/OSAMBot/(list of files, cad)

Other CAD files:
robotic-platform-v1/build/TTLA44T5200-E-20_b-D19-PR.stl
robotic-platform-v1/src/mech/assembly-robotic-platform-individual-parts/belt-tensioner-angle-glider.stp
robotic-platform-v1/build/drive-motor-holder.stl
robotic-platform-v1/build/Zahnrad-Motor-Profil-8M-P24-8M-20-6F.stl
robotic-platform-v1/src/mech/assembly-robotic-platform-individual-parts/TTLA44T5200-E-20_b-D20-PR.stp
robotic-platform-v1/src/mech/assembly-robotic-platform-individual-parts/spring-housing.stp
robotic-platform-v1/src/mech/assembly-robotic-platform-individual-parts/steering-motor-adapter-24.03.25.stp
robotic-platform-v1/src/mech/assembly-robotic-platform-individual-parts/drive-shaft-holder(ALU).stp
robotic-platform-v1/src/mech/assembly-robotic-platform-individual-parts/profile-adapter-plate-24.03.25.stp
robotic-platform-v1/src/mech/assembly-robotic-platform-individual-parts/limit-switch-plate.stp
robotic-platform-v1/src/mech/assembly-robotic-platform-individual-parts/vertical-profile-adapter-plate2.stp
robotic-platform-v0/res/var/Design Data/AIT/Mold Design/mold design stop pin.ipt
robotic-platform-v0/res/var/Design Data/Cable & Harness/en-US/harness.iam
robotic-platform-v0/res/var/Design Data/Tube & Pipe/en-US/piping runs.iam
robotic-platform-v0/res/var/Templates/English/ANSI (in).dwg
robotic-platform-v0/res/var/Templates/English/ANSI (in).idw
robotic-platform-v0/res/var/Templates/English/Mold Design (in).iam
robotic-platform-v0/res/var/Templates/English/Sheet Metal (in).ipt
robotic-platform-v0/res/var/Templates/English/Standard (in).iam
robotic-platform-v0/res/var/Templates/English/Standard (in).ipn
robotic-platform-v0/res/var/Templates/English/Standard (in).ipt
robotic-platform-v0/res/var/Templates/English/Weldment (ANSI).iam
robotic-platform-v0/res/var/Templates/Metric/ANSI (mm).dwg
robotic-platform-v0/res/var/Templates/Metric/ANSI (mm).idw
robotic-platform-v0/res/var/Templates/Metric/BSI.dwg
robotic-platform-v0/res/var/Templates/Metric/BSI.idw
robotic-platform-v0/res/var/Templates/Metric/DIN.dwg
robotic-platform-v0/res/var/Templates/Metric/DIN.idw
robotic-platform-v0/res/var/Templates/Metric/GB.dwg
robotic-platform-v0/res/var/Templates/Metric/GB.idw
robotic-platform-v0/res/var/Templates/Metric/GOST.dwg
robotic-platform-v0/res/var/Templates/Metric/GOST.idw
robotic-platform-v0/res/var/Templates/Metric/ISO.dwg
robotic-platform-v0/res/var/Templates/Metric/ISO.idw
robotic-platform-v0/res/var/Templates/Metric/JIS.dwg
robotic-platform-v0/res/var/Templates/Metric/JIS.idw
robotic-platform-v0/res/var/Templates/Metric/Mold Design (DIN).iam
robotic-platform-v0/res/var/Templates/Metric/Mold Design (mm).iam
robotic-platform-v0/res/var/Templates/Metric/Sheet Metal (DIN).ipt
robotic-platform-v0/res/var/Templates/Metric/Sheet Metal (mm).ipt
robotic-platform-v0/res/var/Templates/Metric/Standard (DIN).iam
robotic-platform-v0/res/var/Templates/Metric/Standard (DIN).ipn
robotic-platform-v0/res/var/Templates/Metric/Standard (DIN).ipt
robotic-platform-v0/res/var/Templates/Metric/Standard (mm).iam
robotic-platform-v0/res/var/Templates/Metric/Standard (mm).ipn
robotic-platform-v0/res/var/Templates/Metric/Standard (mm).ipt
robotic-platform-v0/res/var/Templates/Metric/Weldment (ANSI - mm).iam
robotic-platform-v0/res/var/Templates/Metric/Weldment (BSI).iam
robotic-platform-v0/res/var/Templates/Metric/Weldment (DIN).iam
robotic-platform-v0/res/var/Templates/Metric/Weldment (GB).iam
robotic-platform-v0/res/var/Templates/Metric/Weldment (ISO).iam
robotic-platform-v0/res/var/Templates/Metric/Weldment (JIS).iam
robotic-platform-v0/res/var/Templates/Mold Design/Mold Design.iam
robotic-platform-v0/res/var/Templates/Sheet Metal.ipt
robotic-platform-v0/res/var/Templates/Standard.dwg
robotic-platform-v0/res/var/Templates/Standard.iam
robotic-platform-v0/res/var/Templates/Standard.idw
robotic-platform-v0/res/var/Templates/Standard.ipn
robotic-platform-v0/res/var/Templates/Standard.ipt
robotic-platform-v0/res/var/Templates/Weldment.iam
robotic-platform-v0/src/mech/Fixed_Structure.ipt
robotic-platform-v0/src/mech/Fixed_Structure/Fixed_Structure.iam
robotic-platform-v0/src/mech/Fixed_Structure/Leg.iam
robotic-platform-v0/src/mech/Fixed_Structure/Leg/Frame/104080 1720650304440.ipt
robotic-platform-v0/src/mech/Fixed_Structure/Leg/Frame/Frame 1720650296647.iam
robotic-platform-v0/src/mech/Fixed_Structure/Leg/Frame/Frame 1720650296647_MIR.iam
robotic-platform-v0/src/mech/Fixed_Structure/Leg/Frame/Skeleton 1720650296648.ipt
robotic-platform-v0/src/mech/Fixed_Structure/Leg/Frame/Skeleton 1720650296648_MIR.ipt
robotic-platform-v0/src/mech/Fixed_Structure/LegHolder.ipt
robotic-platform-v0/src/mech/Fixed_Structure/LegHolder_MIR.ipt
robotic-platform-v0/src/mech/Fixed_Structure/LegSketch.ipt
robotic-platform-v0/src/mech/Fixed_Structure/LegSketch_MIR.ipt
robotic-platform-v0/src/mech/Fixed_Structure/Leg_MIR.iam
robotic-platform-v0/src/mech/Frame.ipt
robotic-platform-v0/src/mech/LINEAR_BEARING_80_40/657176.iam
robotic-platform-v0/src/mech/LINEAR_BEARING_80_40/657176_01.ipt
robotic-platform-v0/src/mech/LINEAR_BEARING_80_40/657176_01_MIR.ipt
robotic-platform-v0/src/mech/LINEAR_BEARING_80_40/657176_02.ipt
robotic-platform-v0/src/mech/LINEAR_BEARING_80_40/657176_02_MIR.ipt
robotic-platform-v0/src/mech/LINEAR_BEARING_80_40/657176_03.ipt
robotic-platform-v0/src/mech/LINEAR_BEARING_80_40/657176_03_MIR.ipt
robotic-platform-v0/src/mech/LINEAR_BEARING_80_40/657176_04.ipt
robotic-platform-v0/src/mech/LINEAR_BEARING_80_40/657176_04_MIR.ipt
robotic-platform-v0/src/mech/LINEAR_BEARING_80_40/657176_05.ipt
robotic-platform-v0/src/mech/LINEAR_BEARING_80_40/657176_05_MIR.ipt
robotic-platform-v0/src/mech/LINEAR_BEARING_80_40/657176_06.ipt
robotic-platform-v0/src/mech/LINEAR_BEARING_80_40/657176_06_MIR.ipt
robotic-platform-v0/src/mech/LINEAR_BEARING_80_40/657176_07.ipt
robotic-platform-v0/src/mech/LINEAR_BEARING_80_40/657176_07_MIR.ipt
robotic-platform-v0/src/mech/LINEAR_BEARING_80_40/657176_08.ipt
robotic-platform-v0/src/mech/LINEAR_BEARING_80_40/657176_08_MIR.ipt
robotic-platform-v0/src/mech/LINEAR_BEARING_80_40/657176_09.ipt
robotic-platform-v0/src/mech/LINEAR_BEARING_80_40/657176_09_MIR.ipt
robotic-platform-v0/src/mech/LINEAR_BEARING_80_40/657176_10.ipt
robotic-platform-v0/src/mech/LINEAR_BEARING_80_40/657176_10_MIR.ipt
robotic-platform-v0/src/mech/LINEAR_BEARING_80_40/657176_11.ipt
robotic-platform-v0/src/mech/LINEAR_BEARING_80_40/657176_11_MIR.ipt
robotic-platform-v0/src/mech/LINEAR_BEARING_80_40/657176_12.ipt
robotic-platform-v0/src/mech/LINEAR_BEARING_80_40/657176_12_MIR.ipt
robotic-platform-v0/src/mech/LINEAR_BEARING_80_40/657176_13.ipt
robotic-platform-v0/src/mech/LINEAR_BEARING_80_40/657176_13_MIR.ipt
robotic-platform-v0/src/mech/LINEAR_BEARING_80_40/657176_14.ipt
robotic-platform-v0/src/mech/LINEAR_BEARING_80_40/657176_14_MIR.ipt
robotic-platform-v0/src/mech/LINEAR_BEARING_80_40/657176_15.ipt
robotic-platform-v0/src/mech/LINEAR_BEARING_80_40/657176_15_MIR.ipt
robotic-platform-v0/src/mech/LINEAR_BEARING_80_40/657176_16.ipt
robotic-platform-v0/src/mech/LINEAR_BEARING_80_40/657176_16_MIR.ipt
robotic-platform-v0/src/mech/LINEAR_BEARING_80_40/657176_17.ipt
robotic-platform-v0/src/mech/LINEAR_BEARING_80_40/657176_17_MIR.ipt
robotic-platform-v0/src/mech/LINEAR_BEARING_80_40/657176_18.ipt
robotic-platform-v0/src/mech/LINEAR_BEARING_80_40/657176_18_MIR.ipt
robotic-platform-v0/src/mech/LINEAR_BEARING_80_40/657176_19.ipt
robotic-platform-v0/src/mech/LINEAR_BEARING_80_40/657176_19_MIR.ipt
robotic-platform-v0/src/mech/LINEAR_BEARING_80_40/657176_20.ipt
robotic-platform-v0/src/mech/LINEAR_BEARING_80_40/657176_20_MIR.ipt
robotic-platform-v0/src/mech/LINEAR_BEARING_80_40/657176_21.ipt
robotic-platform-v0/src/mech/LINEAR_BEARING_80_40/657176_21_MIR.ipt
robotic-platform-v0/src/mech/LINEAR_BEARING_80_40/657176_22.ipt
robotic-platform-v0/src/mech/LINEAR_BEARING_80_40/657176_22_MIR.ipt
robotic-platform-v0/src/mech/LINEAR_BEARING_80_40/657176_23.ipt
robotic-platform-v0/src/mech/LINEAR_BEARING_80_40/657176_23_MIR.ipt
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
