new-production-institute/OSAMBot/robotic-platform-v1/doc/concept-design/steering concepts.pdf

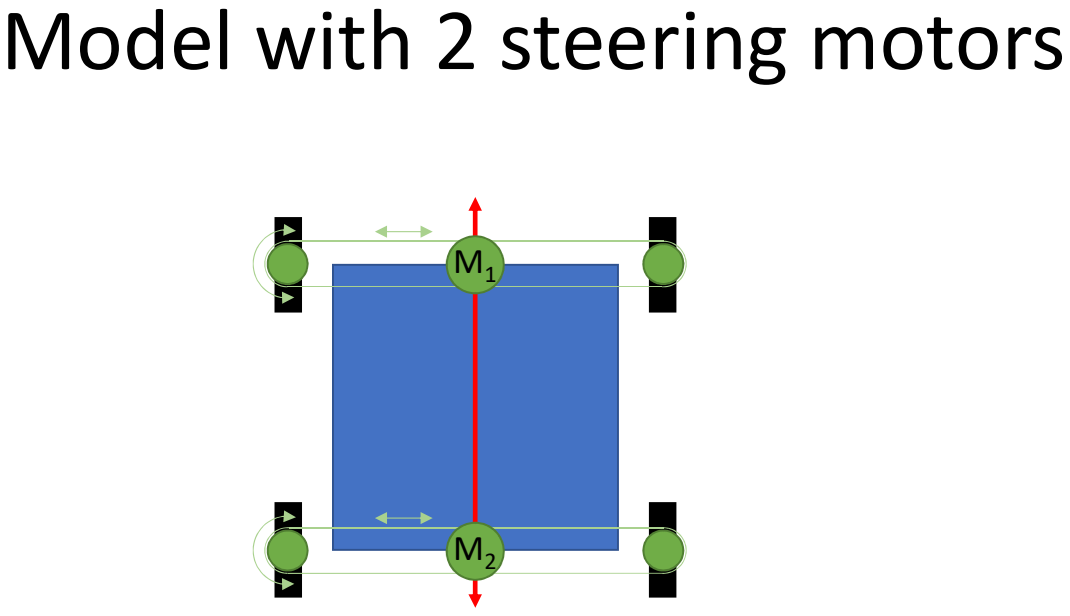
[picture p63: page 1]

Model with 2 steering motors

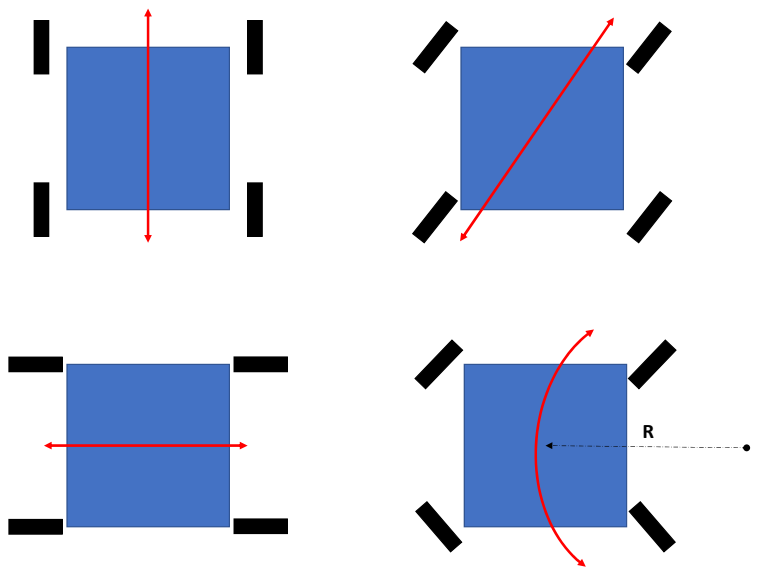
[picture p64: page 2]

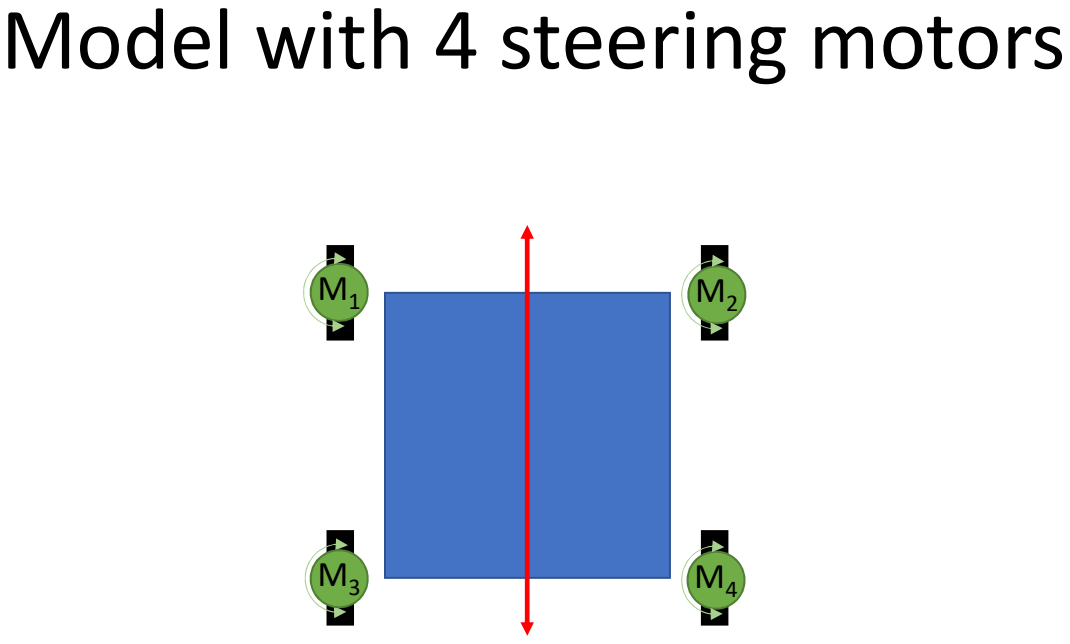
[picture p65: page 3]

Model with 4 steering motors

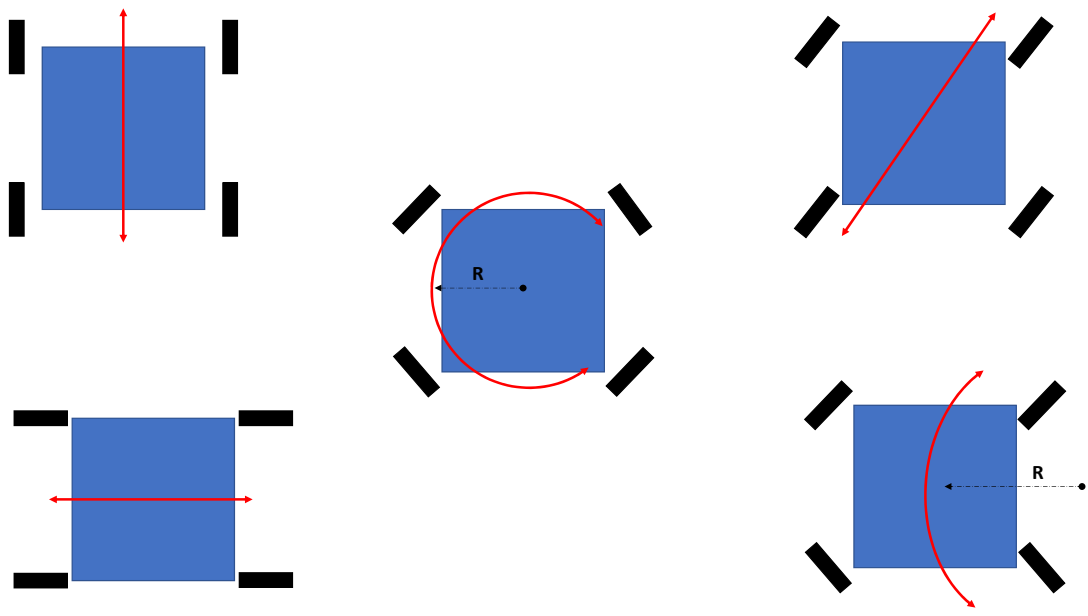
[picture p66: page 4]
