new-production-institute/OSAMBot/robotic-platform-v1/src/mech/assembly-robotic-platform-individual-parts/bearing-limit-ring-V2.pdf

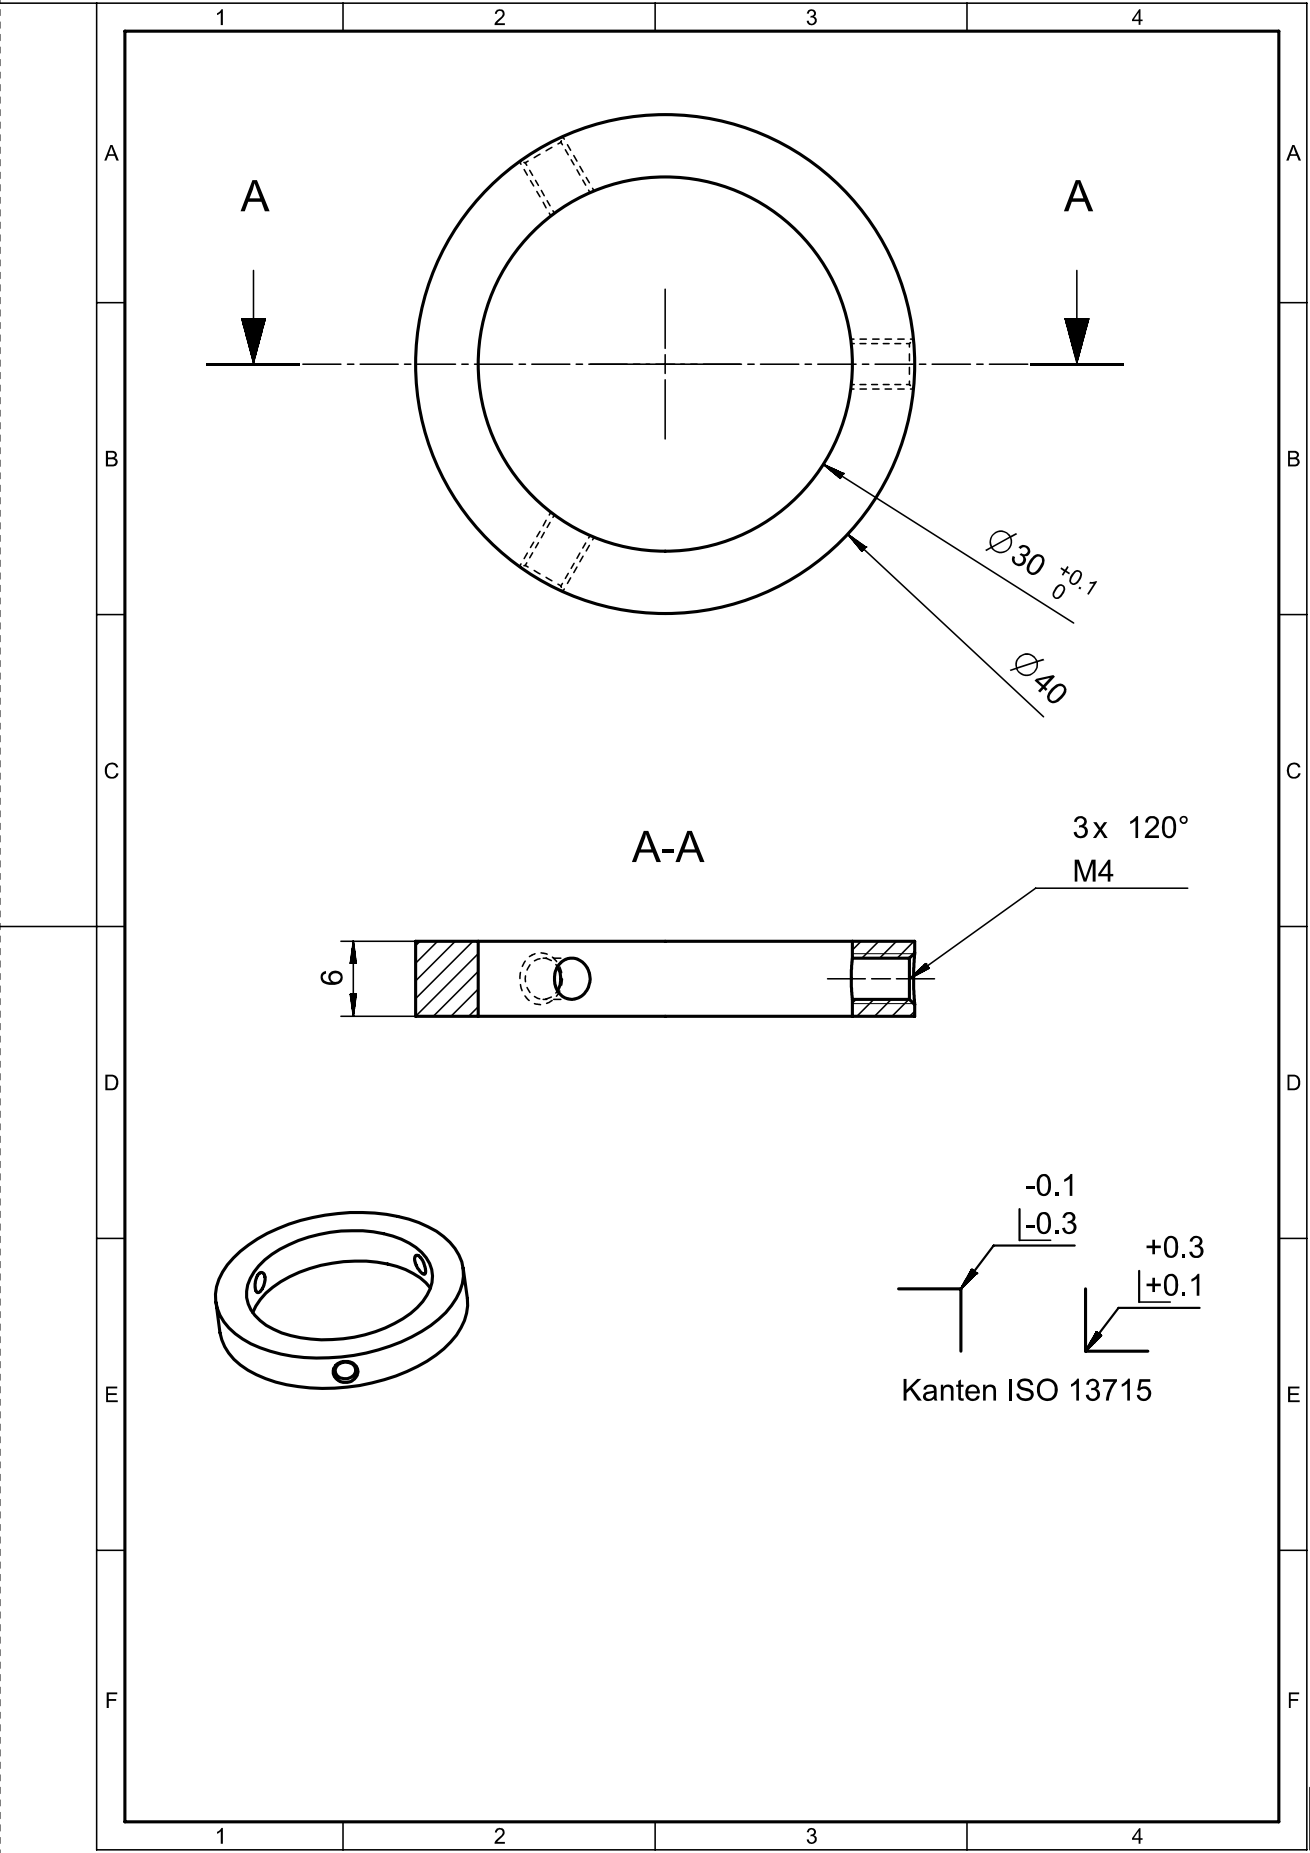
[picture p67: page 1]
