new-production-institute/OSAMBot/robotic-platform-v1/src/mech/assembly-robotic-platform-individual-parts/belt-tensioner-angle.pdf

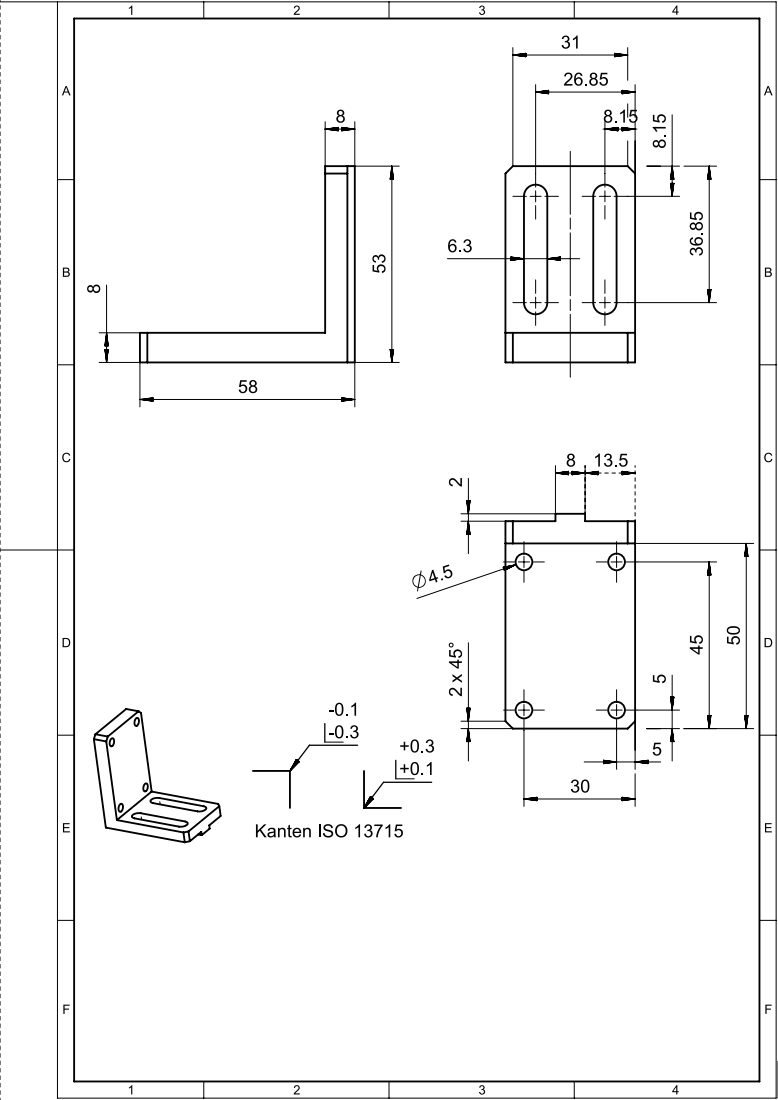
[picture p68: page 1]
Kanten ISO 13715
