new-production-institute/OSAMBot/robotic-platform-v1/res/assets/var/manufacturing/02.04.25/drive-shaft-holder_ALU.pdf

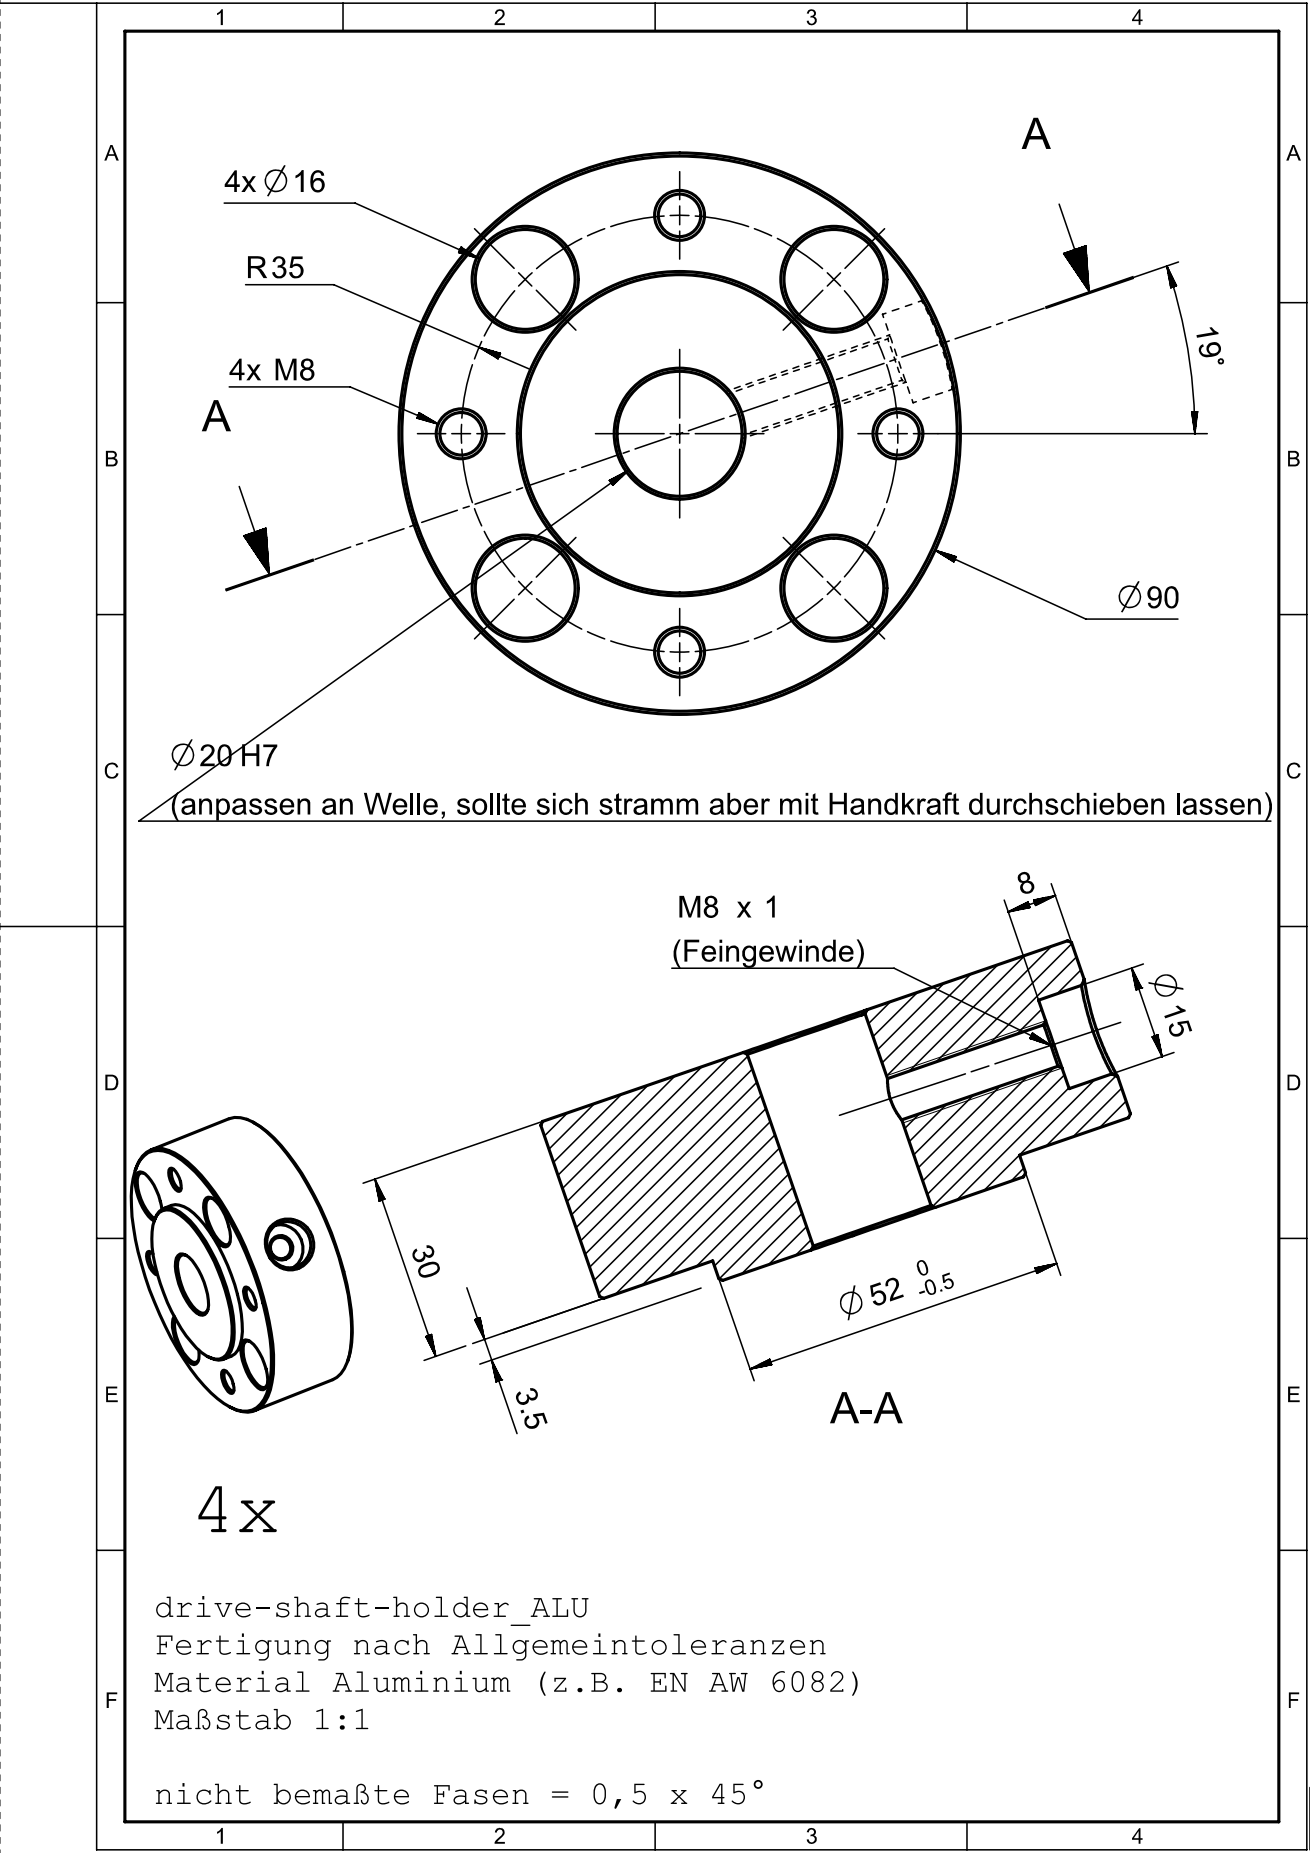
[picture p69: page 1]
