new-production-institute/OSAMBot/robotic-platform-v1/res/assets/var/manufacturing/24.03.25/Motorplate.pdf

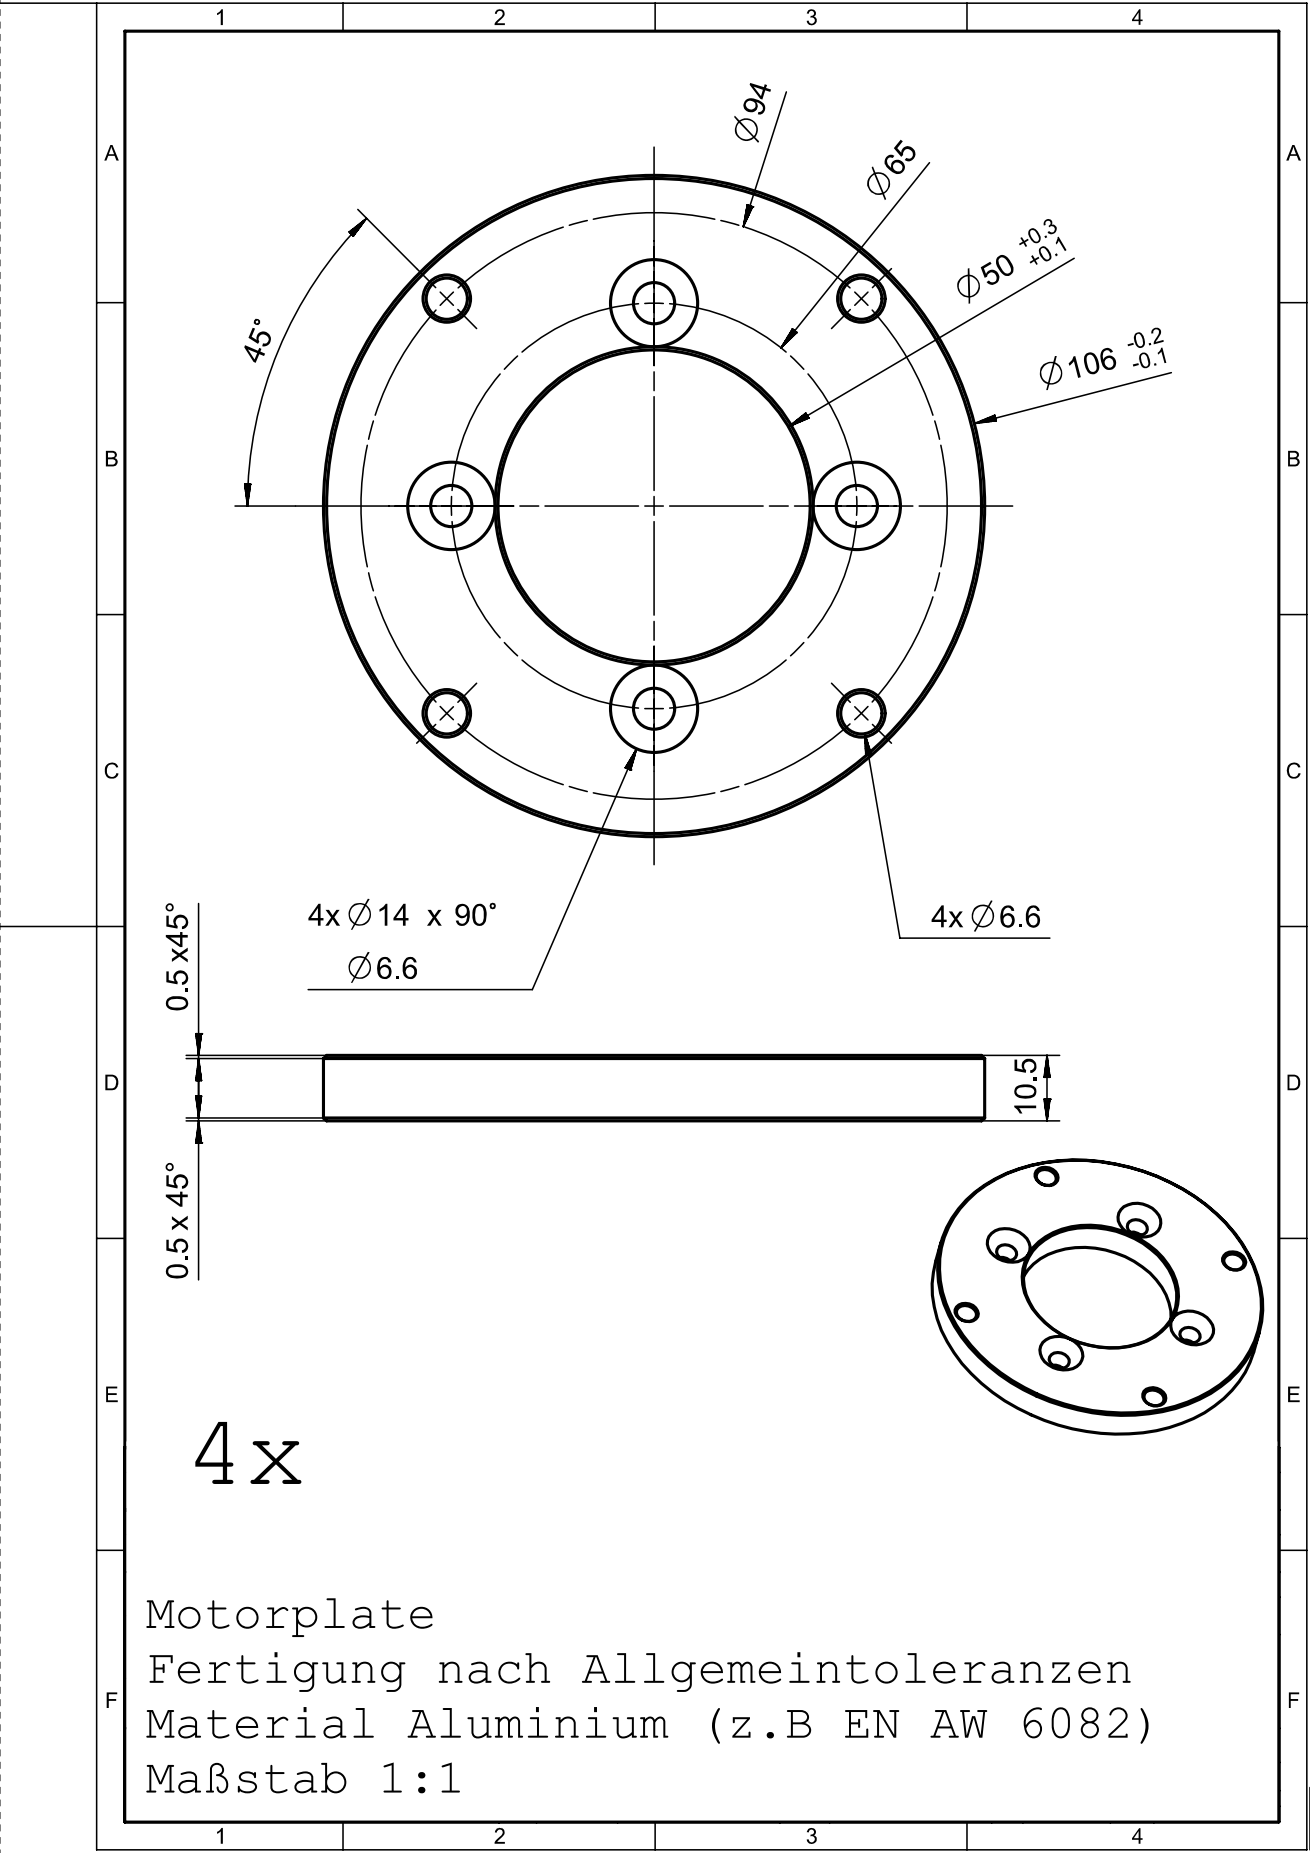
[picture p70: page 1]
