new-production-institute/OSAMBot/robotic-platform-v1/res/assets/var/manufacturing/24.03.25/ProfilAdapterplate-24.03.25.pdf

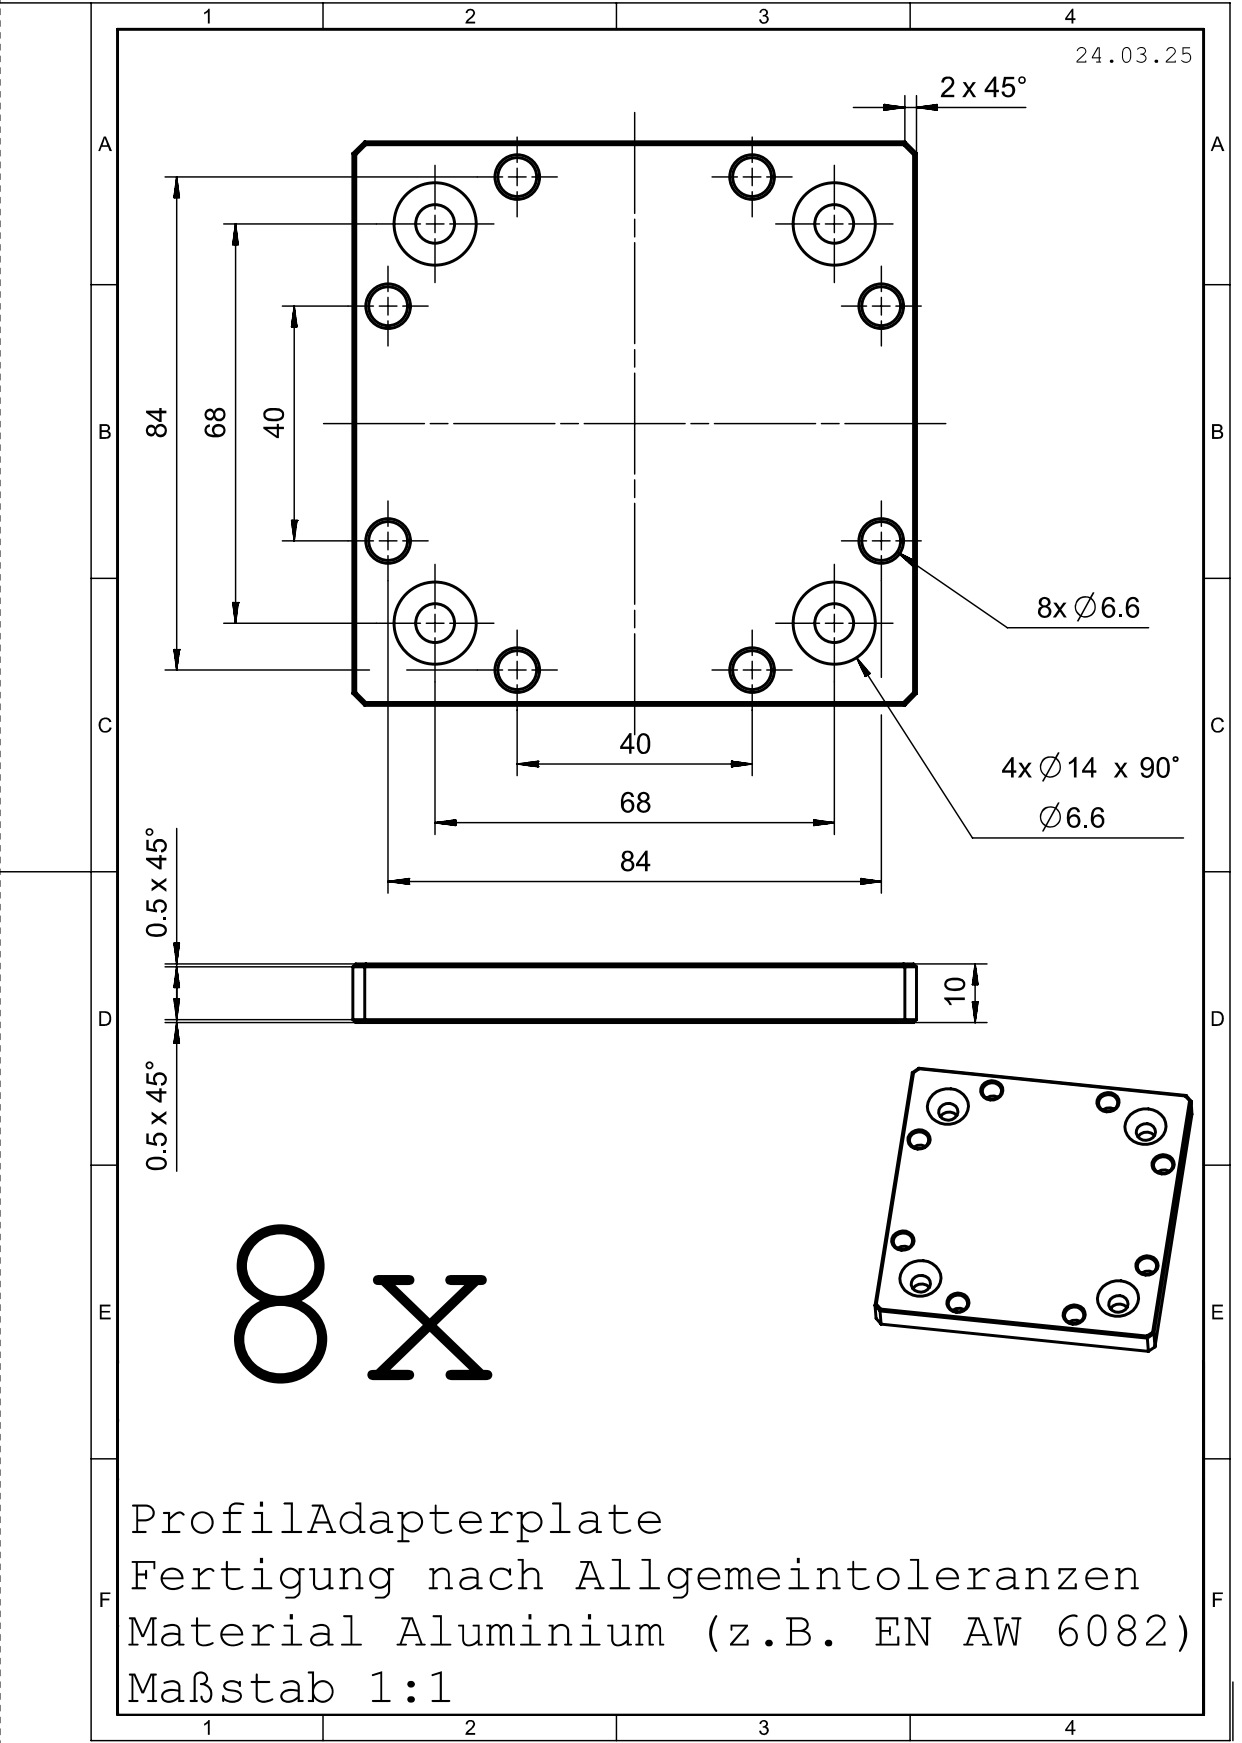
[picture p71: page 1]
