new-production-institute/OSAMBot/robotic-platform-v1/res/assets/var/manufacturing/24.03.25/SteeringMotorAdapter-24.03.25.pdf

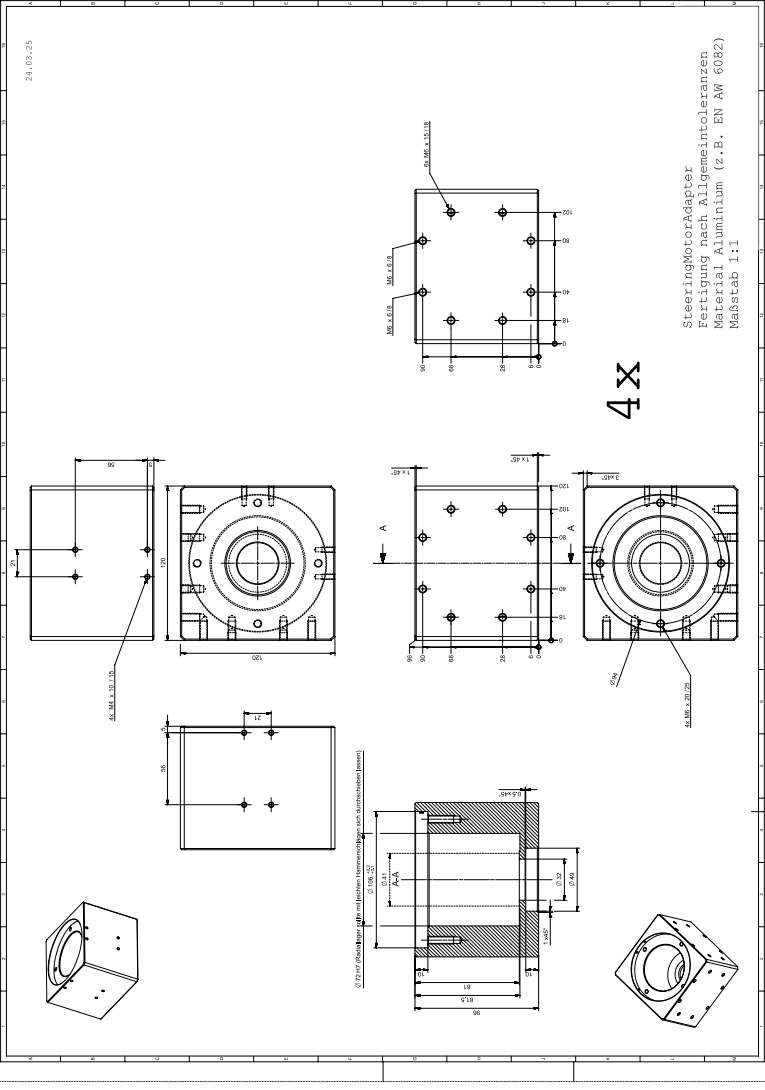
[picture p72: page 1]
