new-production-institute/OSAMBot/(commit log)

2024-08-06 Initial design files from Joel for telescopic platform
    [103030 1711976509749.ipt, 103030 1711976509841.ipt, 103030 1711976509934.ipt, 103030 1711976510015.ipt, 103030 1711976954562.ipt, 103030 1711976954637.ipt, 103030 1711976954722.ipt, 103030 1711976954814.ipt]
2024-08-06 Added the design specs sheets of the motor and encoder for version 1
2025-03-28 update of my CAD files
    after first test of the leg here comes the first CAD-files of the plattform
    [80x80-profile.stp, DrivePR.cfg, Limit switch ME-8108.cfg, Limit switch ME-8108.stp, M4x50.stp, Motor-PL82Z-BL82.137-24300-30S-192_1-ENC1096.stp, Motorplate.stp, ProfilAdapterplate-24.03.25.stp]
2025-04-02 some CAD modifications
    added missing Motorplate
    deleted .log files of the converted step-files
    added modified "drive-shaft-holder_ALU" for manufacturing of luminum
    [Motorplate.stp, drive-shaft-holder(ALU).stp, drive-shaft-holder_ALU.stp, limit-switch-plate.stl, robotic-platform-assembly.cfg]
2025-04-09 added simplified models for simulation
    [Frame.stp, Leg.stp, RiemenRolle.stl, Simplified-Joint-Model.stp, Wheel.stp, bearing-limit-ring-V2.stp, belt-tensioner-angle-glider.stl, belt-tensioner-angle.stp]
2025-04-09 deleted log files of cad files when converting into step
2025-04-10 added a excel table of required screws and washers for assembling
    [table of screws and washers.xlsx]
2025-08-15 added a few of 3d printed helpers
    [Cover-G-Side.stl, Cover-L-Side.stl, Distanzring.stl, Distanzring2.stl, L-Holder.stl, L-HolderV2-T2.stl, L-HolderV2.stl, L-Klemme.stl]
2026-03-16 Reorganise STEP files
    [80x80-profile.stp, Limit switch ME-8108.stp, M4x50.stp, Motor-PL82Z-BL82.137-24300-30S-192_1-ENC1096.stp, Motorplate.stp, RiemenRolle.stp, TTLA44T5200-E-20_b-D19-PR.stp, TTLA44T5200-E-20_b-D20-PR.stp]
2026-03-16 Move misc working in progress files
    [Cover-G-Side.stl, Cover-L-Side.stl, Distanzring.stl, Distanzring2.stl, Frame.stp, L-Holder.stl, L-HolderV2-T2.stl, L-HolderV2.stl]
2026-03-16 Reorganise files
    [DrivePR.cfg, Limit switch ME-8108.cfg, Motorplate.stp, ProfilAdapterplate-24.03.25.stp, RiemenRolle.stl, SteeringMotorAdapter-24.03.25.stp, TTLA44T5200-E-20_b-D19-PR.stl, TTLA44T5200-E-20_b-D20-PR.stl]
2026-03-16 Update and Reorganise files
    [103030 1711976509749.ipt, 103030 1711976509841.ipt, 103030 1711976509934.ipt, 103030 1711976510015.ipt, 103030 1711976954562.ipt, 103030 1711976954637.ipt, 103030 1711976954722.ipt, 103030 1711976954814.ipt]
